alpibrusl/cancho-afm/docs/img-artifacts.png

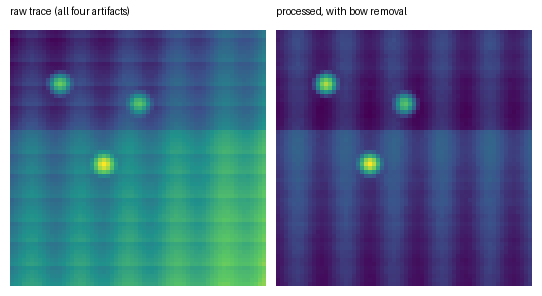
docs/img-artifacts.png
