alpibrusl/cancho-afm/docs/high-speed.md

# High-speed AFM (HS-AFM): design note

> Written 2026-11-03, **before anything is built**. Numbers are **computed from stated assumptions [A]**, taken from a search **[search]**, or not known **[unknown]**.
> Nothing here has run on a cantilever, a photodiode or a fast scanner. The twin results this note asks for are predictions, not measurements.
> This note grows `docs/design.md` section 6 and slice S7. It is the second stage: the tuning fork route (`docs/first-hardware.md`) comes first.

## What changes, and what does not

The software stays: tune, choose, approach, scan, the register table, the lock-in and PID generated from cancho, the twin. What changes is **hardware and a number of
constants**. In the order of difficulty:

| Part | Fork stage (now) | HS stage | Status |
|---|---|---|---|
| Sensor | quartz fork, current through a 1 MOhm TIA | small cantilever, **laser and quadrant photodiode** (optical beam deflection), bandwidth of several MHz | **[unknown]** which cheap photodiode and TIA; the hardest item |
| Resonance | 32.768 kHz, Q about 500 | **0.5 to 1.5 MHz**; Q 2 to 10 in liquid, 100 or more in air **[search]** (Ando: small cantilevers, 450 to 650 kHz in 2001; 1.2 MHz in later work; a commercial one is listed at 1.5 MHz in air, 0.5 MHz in liquid, 0.1 N/m) | cantilevers may be bought; **[unverified]** price and stock |
| ADC | 262 kS/s, 12 bits (Pmod AD1, AD7476A, 1 MS/s) | **4 to 10 MS/s**, 12 bits: at 8 samples per period (what our lock-in needs for a phase-free figure, `docs/converters.md`) 0.5 MHz is 4 MS/s, 1.2 MHz is 9.6 MS/s | AD7476A is too slow (already rejected); AD9226 (12 bits, parallel) is a candidate `docs/converter-candidates.md` **[search]** |
| Drive | DDS word, DAC about 262 kS/s | the same DDS, a DAC at 8 or more times f0 (4 to 10 MS/s) | **[unknown]** part |
| Detector window | 64 samples, 0.24 ms | **16 to 35 samples (2 to 4 whole cycles)**, microseconds | generated lock-in has the window as a register; lockstep run at 18, 23 and 35 (H3) |
| FPGA clock | 27 MHz, timing met at 65.9 MHz estimated | a PLL to 100 MHz or more is wanted for 10 MS/s; Tang Nano 20K has a PLL **[unverified]** | to check |
| Z scanner | the fork's piezo tube or stack, a 1 MOhm-class amplifier (`docs/amplifier.md`) | **small stack, first resonance above 100 kHz** and an amplifier with the bandwidth and slew rate for it; no ringing at the loop rate | **[unknown]**; the amplifier of `docs/amplifier.md` is far too slow for it |
| Z and XY DAC | 16 bits, SPI | settling well under the loop period; SPI at 50 MHz sets the update rate | datasheet values **[unknown]** |
| Sample | any hard sample, air | **a hard sample in air first** (calibration grating); liquid and biological samples are out of scope until air works | scope |

## The bandwidth budget (computed [A], not measured)

A loop update comes from one detector window of `W` samples at the sampling rate `fs` (8 samples per period). The pixel takes `K` updates (the twin's session uses
**K = 20**, "the loop needs about 20 to follow a feature", `host/session.cho`). The cantilever's own response time is `tau = Q / (pi f0)` (Ando) and an amplitude
change settles in about 3 tau. So the pixel time is at least `max(K W / fs, 3 tau)` and the frame rate for `N x N` pixels (trace only) is `1 / (N^2 pixel)`:

| Cantilever | fs | window | tau | pixel (K = 20) | 3 tau | 64 x 64 frame rate |
|---|---|---|---|---|---|---|
| 0.5 MHz, Q = 2 (liquid) | 4 MS/s | 64 samples, 16 us | 1.3 us | 320 us | 3.8 us | 0.8 /s |
| the same | 4 MS/s | 16 samples, 4 us | 1.3 us | 80 us | 3.8 us | 3.1 /s |
| the same | 4 MS/s | 8 samples, 2 us | 1.3 us | 40 us | 3.8 us | 6.1 /s |
| 1.2 MHz, Q = 100 (air) | 9.6 MS/s | 8 samples, 0.8 us | 26.5 us | 17 us | **80 us** | **3.1 /s** (the cantilever limits, not the detector) |

What this says, plainly:

* **The window is the first lever.** Cutting it from 64 to 8 samples gives 8 times the rate, and costs noise (a lock-in over fewer samples is noisier; see the
  noise paragraph below). It also makes the "8 samples per period" rule bite: a window under 8 samples is under one cycle, and the figure is no longer phase-free.
* **In air the cantilever's Q is the limit**, not the electronics: Q = 100 at 1.2 MHz has tau = 26 us. Fast imaging in air needs Q control (active damping) or low-Q
  cantilevers. Q control is not designed here **[unknown]**.
* **10 frames per second** (Ando reports 10 to 25 fps for his instrument **[search]**) at 64 x 64 would need a pixel of 24 us: K = 20 updates of 1.2 us, so a window of
  about 5 samples at 4 MS/s. That is below one cycle and **does not look reachable with a lock-in**. **(HS4 below measured it in the twin and corrected the premise: the window was not what limited the rate.)** Ando uses an RMS-to-DC converter or peak hold and a
  fast scanner, and attributes the limits to cantilever frequency, the RMS-DC rate and the Z scanner bandwidth **[search]**. Our honest target is **1 to 5 frames per second at 64 x 64**, not 10.
* **The one open published controller** reports 55 lines/s, a 512 x 512 image in 9.3 s, for under USD 4,000, on NI hardware (`docs/references.md`). Our cost goal
  is far below that, and our line rate on this budget is also lower **[A]**; neither is measured here.

Noise, which the table ignores: the lock-in's figure noise falls with window length, roughly as 1/sqrt(samples). A window 8 times shorter is about 2.8 times noisier **in theory**; in the twin (H3) the 18-sample window with a snapped drive gave the fork's 28 pm, because its ADC noise is small, so this is not yet seen.
Whether that leaves a usable setpoint depends on the photodiode's noise, **[unknown]**.

## What the twin can and cannot say

The twin (`sim/board.cho`, `sim/plant.cho`) models the cantilever as a Lorentzian with a first-order lag, applied **per ADC sample** with `alpha = pi f0 / (Q fs)`
(clamped at 1). An earlier version of this note said the lag was per window and clamped; that was wrong (read from a comment, not the code) and is corrected here:
at 4.5 MS/s a 0.5 MHz, Q = 5 cantilever has alpha = 0.07, so the lag is modelled, not clamped away. The first-order lag is still the simplest shape: no overshoot.

* **Can, with changes of constants only (H1):** f0 0.5 to 1.2 MHz, Q, free amplitude, the sample rate (`rf[3]`, the divider of the 27 MHz clock: 6 gives 4.5 MS/s), the
  window, pixel divider, a bigger raster; and report the **frame rate the twin predicts**. The tune stage sweeps 32.52 to 33.02 kHz in 8 Hz steps
  (`host/session.cho`): it must sweep a megahertz-scale range, with a wider step. That is a parameter, not new logic.
* **Can, with a small model (H2):** a Z scanner as a second-order system (resonance, damping), and an amplifier slew limit, in `sim/plant.cho`: it shows ringing and the
  line-rate limit **when the loop is faster than the scanner**. The parameters would be guesses until a scanner is measured.
* **Cannot:** photodiode and laser noise, optical alignment, tip-sample dynamics at speed (tapping with very small amplitudes), liquid damping, the real scanner. **(Corrected by HS5 below: the twin does model the lever's amplitude lag and the loss of signal when the tip is a full free amplitude from the sample, which is enough to show parachuting; what it does not model is listed there.)**
  The twin must say so on every HS result, as it does now.

## Slices, acceptance written first

| Slice | What | Acceptance |
|---|---|---|
| H1 | An `hs` profile in the twin: constants only, a larger raster, the frame rate printed | the full procedure (tune, approach, scan) finds a 0.5 MHz, Q = 5 cantilever and scans 64 x 64; the predicted frame rate is within 10% of the table's formula; existing tests unchanged. **Done 2026-11-03, see "What H1 found"** |
| H2 | Second-order Z scanner and amplifier slew in the twin | with the loop faster than the scanner's resonance the twin shows ringing; with a slower one it does not; a test for both. **Done 2026-11-03, see "What H2 found"** |
| H3 | The generated lock-in at 16 to 35 samples per window and 4.5 MS/s, in Verilog | lockstep with the cancho model at several windows at 6 clocks per sample; timing at the clock that gives 8 or more samples per period. **Done for the detector 2026-11-03, see "What H3 found"; the parallel ADC interface is H3b below (done as a block, not wired into the top); the fast drive DAC is not designed** |
| H4 | A video of a fast scan, labelled as a prediction | the video states the frame rate, the window and what is not modelled. **Done 2026-11-03: `docs/hs-vs-fork.mp4`** (the fork and the HS profile scan the same invented sample in simulated real time over 12 s: the fork completes 10% of a frame, the HS profile 18 frames; `docs/make_hs_video.py`) |
| H5 | Parts: a cantilever, a laser and photodiode, a fast ADC and DAC, a small stack and its amplifier | an order list as in `docs/amp-order.md`, with prices **checked** and sources, and what is still **[unknown]** marked. **Done 2026-11-03: `docs/hs-order.md`** (prices read for four lines, snippet-only for the rest, unchecked for the optics and the amplifier) |
| H6 | A measured line rate on a real small cantilever | the S7 acceptance: measured, not predicted; before this, no claim of speed |

H1 and H2 are cancho and need no hardware. H3 is generated hardware and runs under Icarus. H5 and H6 need money and a bench.

## What H1 found (twin, 2026-11-03; predictions, not measurements)

`host/session.cho` takes a profile (`ss[3]`: 0 fork, 1 hs); `host/scan_twin.cho` scans 64 x 64 over the made-up sample for either (`./scan_twin 1`). Hs profile: 4.5 MS/s
(divider 6 of the 27 MHz clock), an 18-sample window, 20 loop updates per pixel, a sweep of 100 to 899 kHz. The full procedure ran with no operator input and no refused write.

* **Tune found the cantilever:** f0 = 508.3 kHz against the twin's 500 kHz (1.7% high: the sweep step is 12.7 kHz), Q = 6 against 5. **(Since HS3, profile 1 settles 17 times longer per sweep point and finds f0 = 487.0 kHz, Q = 4 for the same lever; the 508.3 kHz was biased high by the short settle. Profile 2 is unchanged: 508.3 kHz, Q 6.)** Contact at Z = 2704 pm, as for the fork. A first sweep of 376 to 628 kHz was refused (no resonance well above the floor: the edges were only 2.7 times lower than the peak); the sweep must span several line widths.
* **The window must be a whole number of cycles.** With 16 samples (1.8 cycles at 4.5 MS/s) the amplitude figure rippled by 12% from window to window and the approach saw a false contact at the top of the Z range: the scan was all zeros. 18 samples (2.05 cycles) worked. Of the windows tried (9, 14, 15, 16, 18 at dividers 6 and 7) only 18 at divider 6 completed. **H3 below explains this and fixes it.**
* **Frame rate predicted:** 0.65 s per 64 x 64 frame with trace and retrace, 1.5 frames/s; 3.1 frames/s if only the trace were scanned (the formula's 3.05 to 3.4 /s for a 4 to 4.5 MS/s, 16 to 18 sample window). The twin counts the clocks it simulates, so this agrees with the formula by construction; it is not a check of the formula.
* **The loop did not limit the image: something in the detector did.** Over the same sample the hs image had a trace-minus-retrace rms of 87 pm against 28 pm for the fork's, and the same numbers at 20, 40 and 60 updates per pixel. This note first read that as the cost of a shorter window (about 4% of the figure). **That was wrong, corrected by H3:** it was the beating of a drive that did not span a whole number of cycles per window; with the drive snapped (below) the same 18-sample window gives 28 to 31 pm, the fork's own figure.
* **Not found, because not modelled:** photodiode noise, the real scanner (H2), liquid damping.

## What H2 found (twin, 2026-11-03; predictions, not measurements)

`sim/board.cho` has a Z scanner between the DAC and the tip: a second-order system (resonance, Q) behind an amplifier slew limit, sub-stepped so it stays stable; resonance 0 is the old ideal scanner (every earlier result is unchanged). Three tests (`tests/board_test.cho`): a step of Z
rings when the resonance is high-Q (peak over 1.5 times the step), does not when critically damped, and the slew limit bounds the speed. `./scan_twin <profile> <scanner>` scans through it; the figure is `docs/h2-scanner.png`. All of it a guess until a real scanner is measured.

HS profile, 64 x 64, the loop's gains as the session chooses them (it knows nothing of the scanner), one loop update every 4 us (250 kHz):

| Z scanner | trace-minus-retrace rms | image against the ideal scanner's |
|---|---|---|
| ideal | 87 pm | |
| 100 kHz, Q 3 | 88 pm | 0.998 |
| 70 kHz, Q 3 | 89 pm | 0.996 |
| 50 kHz, Q 3 | 94 pm | 0.979 |
| 30 kHz, Q 3 | 544 pm | 0.38: the loop rings, no image |
| 20 kHz, Q 10 | 896 pm | 0.09: the loop runs away |
| 100 kHz with a 20 pm/us amplifier | 5766 pm | 0.11: fine on the flat part, then a limit cycle from the terrace step on |

* **The scanner's resonance must be about a fifth of the loop update rate or more** for these gains: 50 kHz works, 30 kHz does not. The fork profile (a 4 kHz loop) is unaffected even by a 20 kHz, Q = 10 scanner. That is the acceptance: ringing when the loop is faster than the scanner, none when slower.
* **A slew limit breaks the loop at a step**: with 20 pm/us the amplifier cannot follow the 150 pm terrace within a loop update, and the loop oscillates. An amplifier for HS has to be specified in pm per us for the largest step, not only in bandwidth.
* **The session's gain choice (`tune.choose`) ignores the scanner.** Taking its resonance into account, or a slower loop, would widen what works, at the cost of rate. Not done; the table is for the gains as they are. **(Done in part by HS7 below: a scale from the scanner's resonance.)**
* **Not shown:** a measured scanner, hysteresis and creep, the amplifier of `docs/amplifier.md` (far too slow: its bandwidth is for the fork).

## What H3 found (generated Verilog and the twin, 2026-11-03)

**The detector.** The generated lock-in (`gen/lockin_ir.cho`, unchanged: the window is a register) was fed one sample every 6 clocks (4.5 MS/s from 27 MHz) over three windows (18, 23, 35 samples, drives at 2, 2 and 4 whole cycles): 36 windows,
**0 mismatches** against `sim/lockin.cho` under Icarus (`gen/lockin_hs_tb.v`, in `gen/check.sh`). The amplitude arrives **13 clocks (0.48 us)** after the window closes. It accepts a sample every clock, and its place and route
gave Fmax 83.3 MHz (`gen/README.md`), so **no PLL is needed for the detector**: 27 MHz allows up to 27 MS/s and the divider (3 for 9 MS/s, 6 for 4.5) is a register. What is not designed: the ADC itself (the Pmod AD1's SPI is 1 MS/s at most; a 12-bit parallel part such as the AD9226 needs a new generated interface block), the fast drive DAC, and the pins.

**Why windows failed in H1, and the fix.** A square-wave lock-in is steady only if each window sees the same sample phases, i.e. m whole cycles in n samples. Spanning "about" a whole number of cycles is not enough: windows of 2.02 cycles still beat by 6% at 400 kHz.
So `lockin.snap` (`sim/lockin.cho`) snaps the drive to `fs m / n` within 1/(8 Q) of the tuned frequency (under 2% of the amplitude lost) and takes the shortest such window; the session uses it for the HS profile after the sweep (window and tuning word, `ss[15]`, `ss[18]`). Tests: the snap picks
n = 18, m = 2 at 508 kHz, Q 6 (500 kHz, 9 samples per period exactly, word 477218588) and n = 23, m = 2 at 395 kHz; a steady sine's figure is identical every window at the snapped drive (spread of at most 1 count) and ripples by more than 1,000 counts at 1.8 cycles in 16 samples.

**In the twin**, a cantilever anywhere from 300 to 600 kHz (Q about 5) now tunes, approaches and scans 64 x 64 with no operator input, where only 500 and 600 kHz worked before:

| f0 | window | frame (trace+retrace) | trace-minus-retrace rms |
|---|---|---|---|
| 300 kHz | 29 | 1.04 s | 28 pm |
| 400 kHz | 23 | 0.82 s | 29 pm |
| 450 kHz | 20 | 0.72 s | 29 pm |
| 500 kHz | 18 | 0.65 s | 30 pm |
| 550 kHz | 16 | 0.57 s | 30 pm |
| 600 kHz | 16 | 0.57 s | 31 pm |

* **Limits**: at 4.5 MS/s a cantilever above fs / 8 = 560 kHz has fewer than 8 samples per period (the profile above 600 kHz was not made to work; it needs the divider 3 or 4, 9 or 6.75 MS/s, chosen from the tuned frequency: not done). The snap assumes the drive can be set to the snapped frequency without losing the cantilever, true for a Q of about 5 and to be checked for the 100 or more of air.
* **Twin, not measured:** the noise numbers are the twin's own (ADC noise of 2 counts, no photodiode), and its sampling is ideal.

## What H3b found (generated Verilog, 2026-11-03)

`adc_par` (`sim/adc_par.cho`, `gen/sv.cho`, details and checks in `gen/README.md`) is the interface to the AD9226 module: it drives the ADC clock, captures 12 bits and OTR, drops the 7 pipeline-filling captures and reports. Lockstep against the cancho model, a protocol test against a datasheet-based chip model with the 10 ns worst-case output delay (data settled 27 ns before capture at 13.5 MS/s), place and route 146 MHz. **The datasheet says the latency is 7 clocks, not the 3 I first assumed**, which the protocol test would have caught as well. The 7-sample delay does not matter to the lock-in (it is phase-blind), but it is a delay in the loop: 7 conversions, 1.6 us at 4.5 MS/s, before the first sample of a window reaches the detector.
Not done: wiring it into `afm_top` (a register to choose between the SPI and the parallel ADC changes the register table), pin assignments, the module's MODE strap, and a real chip.

Image processing of the result (levelling, roughness, step height, pitch, particles) is designed in `docs/image-processing.md`.

## What HS1 found (twin, 2026-11-09; predictions, not measurements)

Issue #64. The frame rate the twin predicts when the loop steps per pixel (`pixdiv`) are cut, with the Z scanner's resonance as the second axis. 64 x 64, trace and retrace, a 1,000 pm step in the made-up sample, the loop's gains as the session chooses them, no noise. **One run per cell; the twin is deterministic here.** Profile 1 is the cantilever at the twin's default Q of 5; profile 2 is the liquid one at Q 3. The figure of merit is the **trace-minus-retrace rms over columns 2 to 61** (pm): it grows when the loop lags the surface. (It is not the 87 pm of H1 above: that was another sample, with a 150 pm step, over all columns. The two are not comparable.)

| loop steps per pixel | frame time | frames/s | profile 1: ideal / 70 kHz / 50 kHz / 30 kHz scanner (pm) | profile 2: ideal / 70 / 50 / 30 kHz (pm) |
|---|---|---|---|---|
| 20 | 0.645 s | 1.55 | 9 / 10 / 12 / **525** | 9 / 14 / 112 / **306** |
| 10 | 0.323 s | 3.1 | 45 / 43 / 52 / **548** | 56 / 69 / 146 / **243** |
| 6 | 0.194 s | 5.2 | 75 / 85 / 123 / **600** | 98 / 89 / 168 / **429** |
| 4 | 0.129 s | 7.7 | 135 / 125 / 111 / **722** | **481** / **523** / **497** / **889** |

* **The frame time is the loop steps per pixel times a constant** (32,260 us per step). It is the twin counting its own clocks, so it agrees with the formula by construction; it checks nothing about a real instrument. Pinned in `tests/hs_rate.sh` for 20, 10 and 4.
* **The step height is not a sensitive figure:** every cell with a scanner at 50 kHz or faster reads the 1,000 pm step within 0.5%. The lag in the trace-minus-retrace figure is what degrades first.
* **Against an error bound of 100 pm (my proposal, not derived):** profile 1 holds it at 3.1 frames/s with a scanner of 50 kHz or faster and at 5.2 with 70 kHz or faster; profile 2 holds it at 3.1 with 70 kHz or faster, never with a 50 kHz scanner (112 pm already at 1.55 frames/s), and its 7.7 frames/s run is lost whatever the scanner is. A 30 kHz scanner fails everywhere (as in H2). **The design note's goal of 1 to 5 frames/s at 64 x 64 stands for the twin only if the Z scanner resonates at 70 kHz or more**; a 50 kHz one caps it near 3 in air and below 1.5 in liquid.
* **The detector window was not swept.** `lockin.snap` picks the shortest window of at least 16 samples that fits a whole number of cycles at 8 or more samples per period, so the window is 18 here and cannot be cut by a constant. Windows under one cycle are the fast detector of issue #67.
* **The profile called "air" is not air.** Profile 1 defaults to Q 5. Asked for a cantilever of Q 20 and Q 50 the tune stage finds Q 17 and Q 21 (probably the 12.7 kHz sweep step: the line is 25, 10 and 5 kHz wide at Q 20, 50 and 100, so it is under-sampled and Q reads low; the cause was not isolated), and **at Q 100 it refused with code 21 (peak at the edge of the sweep)**: an air cantilever was not supported by the tune. **Corrected by HS3 below: the cause was the settle time, not the step, and Q 100 now completes.** Every "air" figure above (and in `docs/liquid.md`) was a low-Q figure, which HS3 now separates from Q 100.

## What HS2 found (twin, 2026-11-09; predictions, not measurements)

Issue #65. Rule 5 of the approach, the step budget: **the approach is host-driven, one script exchange per step, and its worst case is linear in the Z range.** `approach.worst_steps(p)` is `(max_motor + 1) * ((range / dz + 2) * (dwell + 1) + 4 * dwell)`; `approach.check_budget` refuses a range whose worst case plus 1,000 steps for the other stages exceeds `session.step_budget()` (100,000, an assumption: the time per step on a real link is not measured), with **failure code 35**, before anything moves. `max_motor` is now derived from the farthest initial gap the approach is asked to cover (`session.gap_max()` = 12,000 pm; the twin's gap is 11,000), not fixed at 20, so the worst case is 4 descents instead of 21.

| Z range | worst-case steps | result |
|---|---|---|
| 10 nm | about 9,500 | completes; steps up to 6 nm within 0.2%; 8 and 20 nm steps clipped at 7.2 nm (the range) |
| 100 nm | about 86,200 | completes (contact Z 2,656 pm); steps of 3, 8, 20 and 50 nm read within 0.1% |
| 1,000 nm | about 860,000 | **refused, code 35** |

* **The 7.2 nm clip of `docs/liquid.md` was the range, not the loop.** Corrected there in place.
* **What it costs:** a range ten times larger is ten times the approach steps. Not designed: a far-field descent in bigger moves, which would cut it.
* **Two hidden limits were found on the way:** `session.consume` had its own cap of 40,000 calls (code 6), apart from the hosts' loop caps of 40,000; both now read `step_budget()`. Before #62 a spent cap ended with code 0.
* **Not covered:** the real scanner's range (a guess, about 1 um), the hysteresis and creep that a large range brings, and the force at a large range (not measured).

## Open slices, as issues

#64 HS1, #65 HS2, (the twin side of) #66 HS3, #72 HS7 and #68 HS5 are above. #67 HS4 tested its premise (above) and built nothing. Not started: #69 HS6 (hardware; blocked on a bench).

## What HS3 found (twin, 2026-11-09; predictions, not measurements)

Issue #66. An air cantilever of Q 100 has a response time tau = Q / (pi f0) = 64 us at 500 kHz, and the loop gets a new reading every 4 us. Three things were built in the twin and cancho; the Verilog and the real feedback path were not.

1. **The tune could not see a Q of 100, and the cause was the settle time.** The sweep waited 37 us per point (eleven time constants of a Q = 5 lever) before reading; a Q = 100 lever needs five of 64 us. Profile 1 now waits 630 us per point (five time constants of a Q = 200 lever); profile 2 keeps 37 us, so the liquid numbers do not move. With that alone the sweep completes (Q read as 41).
2. **A second, finer pass** (`session.sweep_hz`, `ss[26]`): when the coarse pass finds a line narrower than four of its steps (`coarse_step()` = 12.7 kHz), the line is swept again, centred, with a step of f0 / (8 Q). Q reads 85 for a Q 100 lever and 86 for a Q 200 one (it reads low as the line narrows: the settle is only five time constants at Q 200); 23 and 46 for Q 20 and 50. **A fault found on the way: my first version refined every line, and for a liquid lever (Q 3) the fine pass started at a negative frequency and the program died with a trap (exit 132).** Now refined only for narrow lines and the start is clamped at 50 kHz. `tuning_word` itself still does not guard a negative frequency; the callers do.
3. **Q control** (`sim/qcontrol.cho`, `board.set_qcontrol`, `scan_twin` arguments 22 and 23: the gain in tenths and the phase error in degrees): Q_eff = Q0 / (1 + g cos(phi)). Unstable feedback (1 + g cos(phi) below 0.1) is refused with **code 85** before anything runs. The tune sees the damped lever (Q control is on from the start; in a real instrument it would be switched on after the first sweep).

Q 100 in air, 64 x 64, the ideal scanner, a 1,000 pm step, no noise; the figure is the trace-minus-retrace rms (pm) as in HS1; one run per cell:

| loop steps per pixel | frames/s | no control | gain 4 (Q 20) | gain 9 (Q 10) | gain 19 (Q 5) |
|---|---|---|---|---|---|
| 160 | 0.19 | 39 | | 2.5 | |
| 80 | 0.39 | **74** | | 2.9 | |
| 40 | 0.77 | 466 | | 4.5 | |
| 20 | 1.55 | **1,014** | 53 | 11 | 8.1 |
| 10 | 3.1 | 802 | 567 | 93 | 38 |
| 6 | 5.2 | 535 | 935 | **92** | 90 |
| 4 | 7.7 | 363 | 954 | 467 | 85 |

* **Without Q control the lag stays under 100 pm only at 0.39 frames/s or slower**; with a gain of 9 it stays under 100 pm up to 5.2 frames/s. That is **about 13 times the rate, for a Q 10 times lower**, as tau = Q / (pi f0) suggests. A gain of 19 reproduces the Q 5 scan of HS1 exactly (8.1, 38, 90 pm), which checks the plumbing (pinned in `tests/hs_rate.sh`).
* **The lag figure is not monotonic where the loop is marginal** (gain 4 is worse than none at 6 and 4 steps per pixel). One run per cell; the table is not a smooth law.
* **The phase error matters** (gain 9): at 45 degrees the lag is 60, 66, 474 and 812 pm at 20, 10, 6 and 4 steps per pixel (fine up to 3 frames/s, lost at 5); at 80 degrees it is lost everywhere; at 100 degrees it is refused (85). The feedback path would need a phase held well inside 45 degrees. **For scale: one sample of the 4.5 MS/s converter is 40 degrees of a 500 kHz cycle**, so a path of several samples is a design problem of its own, not designed here.
* **Not modelled, and each one decides whether this pays on a real lever:** the noise the feedback adds (the main practical cost), the resonance shift (g sin(phi) / (2 Q0)), the drive range (a gain of 9 holds the free amplitude with ten times the drive), a detector or DAC that is not instantaneous, and the lever's own higher modes.
* **Verdict for #66:** in the twin the idea pays by an order of magnitude. That is the condition the issue set for generating Verilog; **the Verilog was not written**, because the part that would decide it (the feedback path's delay and noise at 500 kHz) is not in the twin. #66 stays open for the design of that path.

## What HS4 found (twin, 2026-11-09; predictions, not measurements)

Issue #67 asked for a detector that works on windows under one cycle (peak hold or RMS-DC), on the premise that **the lock-in's window is what limits the frame rate**. The issue's own condition was that HS1 show it. I tested the premise before building anything, and **it does not hold in the twin, so no detector was built.**

How it was tested. `lockin.snap` was allowed to pick a one-cycle window (m = 1, n = 9 at 500 kHz) in a scratch copy: it runs, and the figure is half as large (it is proportional to the window). At **equal frame time** the 9-sample window gets twice the loop updates per pixel. Q 100 damped to Q 5 (gain 19), and the liquid lever (Q 3); ideal Z scanner; trace-minus-retrace rms (pm); one run per cell. Gains scaled 25 to 300% of the tune's choice, the best shown:

| frames/s | lever | window 18 at the chosen gains | window 9 at the chosen gains | window 18, best gains | window 9, best gains |
|---|---|---|---|---|---|
| 5.2 | Q 5 | 90 | 89 | 90 (100%) | **31** (300%) |
| 7.7 | Q 5 | 85 | 199 | 75 (150%) | 64 (150%) |
| 10.3 | Q 5 | 310 | 540 | 50 (200%) | 56 (200%) |
| 5.2 | liquid Q 3 | 98 | 154 | 53 (300%) | 45 (300%) |
| 7.7 | liquid Q 3 | 481 | 685 | 54 (200%) | 61 (300%) |
| 10.3 | liquid Q 3 | 819 | 1,143 | 57 (300%) | 84 (300%) |

* **The shorter window is not better**: with the chosen gains it is the same or worse in every cell, and at the best gains it wins in 3 cells of 6 by a few pm and loses in the other 3. The one clear win (5.2 frames/s, Q 5: 31 against 90 pm) is a single gain scale; its neighbours (200%: 72, 150%: 89) do not repeat it. Pinned for 10.3 frames/s in `tests/hs_rate.sh`.
* **What did limit the rate is the loop gain rule.** `tune.choose` aims the loop gain at half the lever's response per update, and at 10.3 frames/s that is too timid for an ideal scanner: doubling the gains cuts the lag from 310 to 50 pm (liquid: 819 to 57 pm at three times). **So 10 frames/s at 64 x 64 is reachable in the twin with the same 18-sample window, but only with an ideal scanner** (next bullet). The earlier line of this note that 10 fps needs a window of about 5 samples was wrong about the cause.
* **That only holds with an ideal Z scanner.** At 10.3 frames/s with Q 5: a 70 kHz scanner gives 288 pm at the chosen gains, 450 at twice and 958 at three times; a 50 kHz one 267, 854 and 2,109; a 30 kHz one is lost at every gain. **Higher gains make a real scanner ring (H2 again): the scanner, not the detector and not the gain rule, is what sets the limit at 10 frames/s.** The gain rule ignores the scanner (said in H2; not fixed).
* **Detector noise did not matter in the twin** (0 to 30 counts at gains 1, 2 and 3 times: 819/205/57 pm against 780/187/64 pm at 30 counts). That is small against a figure of about 12,000 counts and is not a statement about a real photodiode and amplifier.
* **A knob was added to measure this:** `scan_twin` argument 24 scales the chosen gains in percent (`sf[6]`); 0 is as chosen.
* **What this leaves for #67:** the issue's acceptance cannot be met honestly; the condition it depended on is false in the twin. It is not closed: a peak-hold detector could still matter for reasons the twin does not model (a window of 4 us adds a delay the loop sees; a real photodiode's noise against a shorter window). Both need the hardware (#69). The next measurable thing is a loop gain rule that knows the Z scanner (issue #72).

## What HS7 found (twin, 2026-11-09; predictions, not measurements)

Issue #72. A gain rule that knows the Z scanner. **Built, with one regression on cells it was not fitted to.**

**The pattern.** On a grid of 40 twin runs (Q 5 and liquid Q 3 levers; ideal, 100, 70, 50 and 30 kHz scanners; 10, 6, 4 and 3 loop steps per pixel; gains scaled 25 to 300% of the tune's), the gain at which the lag blows up tracks the scanner's resonance against the loop's update rate (250 kHz here): a 30 kHz scanner loses the loop above about 0.6 of the chosen gains, 50 kHz above 1.1, 70 kHz above 1.6, 100 kHz above 2.3, an ideal one not below 3. Below that limit, more gain is better.

**The rule** (`tune.scanner_scale`): scale the chosen gains by `5 f_scan window_s`, kept between 0.1 and 1.5; `f_scan` unknown (0) leaves them alone. The 5 and the 1.5 are the pair, among those tried, that never made a grid cell more than 1.5 times worse than the unscaled gains and cut the geometric-mean lag from 215 to 146 pm (the best any gain gave per cell: 107 pm; 24 cells of 40 under 100 pm against 15 for the old gains and 17 for the rule). **Those figures for the rule are interpolated between the measured gain scales, not re-run at the rule's gain; only the held-out cells below are real runs of the rule.** **They are a fit to the twin's scanner model, a guess about a real scanner.**

**The refusal** (`tune.pixel_reachable`, code **36**, before the approach): a pixel shorter than 0.7 of the scanner's period (`updates * window_s * f_scan < 0.7`). In every grid cell below 0.7 the lag was 575 pm or more at any gain tried; the cells above 0.7 are not all good, and the rule says nothing about them. It is a refusal of the hopeless, not a promise.

**How the host learns the scanner:** `sf[7]` holds the resonance in Hz (0 = not known, the default); `scan_twin` argument 25 = 1 tells the host the twin's own value. In a real instrument it would be measured (a step test of the Z stack, needs #69). Every earlier result is unchanged because the default is "not known".

**Checked on cells not used to fit it** (3 pixel times of 20, 8 and 5 steps, a 20 kHz Q 10 scanner and 30, 50 and 70 kHz ones, both levers: 24 cells):

* **6 refused with 36** (20 kHz at 8 and 5 steps, 30 kHz at 5 steps); the unscaled lag of every one was 581 to 1,209 pm, so none was a good run lost.
* **7 clearly better:** 20 kHz Q 10 at 20 steps 931 to 364 pm (Q 5) and 1,255 to 237 pm (liquid); 30 kHz at 20 steps 919 to 284 and 306 to 156; at 8 steps 914 to 299 and 311 to 202; 70 kHz liquid at 5 steps 273 to 70.
* **8 unchanged** (within 10%): all six 50 kHz cells (the scale is exactly 1.0 there), and 70 kHz at 8 steps (Q 5) and 20 steps (liquid).
* **3 worse:** 70 kHz Q 5 at 20 steps 9 to 15 pm (small), 70 kHz liquid at 8 steps 77 to 94 pm, and **70 kHz Q 5 at 5 steps 90 to 142 pm (1.6 times)**. So the property "never more than 1.5 times worse" held on the grid it was fitted on and **failed once off it**. The 70 kHz cells, where the scale is 1.4 and the limit is about 1.6, sit too near the edge; a scale of 1.2 would likely fix them, and I did not tune it further on the held-out cells, which would have made them fitting data too.
* **After 100 pm:** the rule leaves a large gap to the best per-cell gain (the best gain also depends on the lever and the pixel time, not only the scanner), and a 50 kHz scanner is not helped at all.

**Not modelled:** a scanner with a slew limit (`scan_twin` scanner 3 reports 100 kHz and is treated as such), hysteresis and creep, the scanner's own Q (the table used Q 3, and Q 10 for the 20 kHz one), and the amplifier. The scanner's resonance is an input the host must be given.

## What HS5 found (twin, 2026-11-09; predictions, not measurements)

Issue #68 said the twin has no tip-sample dynamics at speed. **That was too strong, and is corrected here.** The twin has two things that produce parachuting: the amplitude follows its target with the lever's own response time (a first-order lag per ADC sample, `alpha = pi f0 / (Q fs)`, `tau = Q / (pi f0)`), and the target is the free amplitude whenever the tip is a free amplitude or more from the sample (`gap >= free`: the signal saturates, so the loop knows only that it is far, not how far). What was missing was a **measurement** of it, which this adds: `scan_twin` argument 26 = 1 prints `airborne_windows A of N`, the detector windows in which the tip was a full free amplitude from the sample (the board's `fl[44]` and `fl[45]`).

Profile 2 (liquid, Q 3), a 100 nm Z range so the made-up sample's particles (4 times the step) fit, lever 0.15 N/m (rigid sample), the loop gains as chosen, 64 x 64 with trace and retrace, one run per cell. The share of the detector windows with the tip off the surface:

| step | 1.55 frames/s | 3.1 | 5.2 | 10.3 |
|---|---|---|---|---|
| 500 pm | 0.1% | 0.3% | 0.5% | 1.8% |
| 1,000 pm | 0.5% | 0.9% | 1.6% | 4.3% |
| 4,000 pm | 1.9% | 3.9% | 7.1% | **13.0%** |
| 8,000 pm | 2.8% | 5.8% | 9.3% | 15.7% |

* **Parachuting is a fixed time, not a fixed distance.** For the 4 nm step the count of airborne windows is the same at every rate (3,039, 3,145, 3,435 and 3,142), so a faster line, with fewer windows per pixel, covers more of the image while the tip is up: 1.9% of the image at 1.55 frames/s, 13% at 10. A step under the free amplitude (500 pm against 2,000) barely does it (0.1% at the slow rate). Pinned in `tests/hs_rate.sh`.
* **More loop gain shortens it** (4 nm step, 10.3 frames/s): 3,731 airborne windows at half the chosen gains, 3,142 at the chosen, 2,146 at twice, 1,636 at three times (15.4% down to 6.8%). That is another reason the gain rule of HS4 and HS7 matters, and it pulls against the scanner's limit on gain (HS7).
* **The per-pixel force map misses the transient, and it matters more at speed.** The largest force in any detector window against the largest in the per-pixel map, in pN (the proxy is capped at 300):

| step | 1.55 frames/s | 3.1 | 5.2 | 10.3 |
|---|---|---|---|---|
| 1,000 pm | 248 / 42 | 239 / 73 | 230 / 81 | 242 / 169 |
| 4,000 pm | 300 / 118 | 300 / 205 | 300 / 202 | 300 / 300 |

  At the slow rate the map reads about a sixth of the largest window force on a 1 nm step. At the fast rate it catches up because each pixel is a few windows long, which says the map is a sampling artefact of the pixel time, not a better measurement. **Neither is a measured force**; both are the same linear law (stiffness times the amplitude given up).
* **Parameters of the model, all guesses until a lever is measured:** `tau` from the tuned Q and f0, the contact law `amplitude = free * gap / free` for gaps under the free amplitude, the loop gains, and the 2 nm free amplitude.
* **Not modelled:** a tip-sample force law (the contact is linear, not the real attraction and repulsion), the lever falling faster in contact than it rises off the surface (dissipation on contact; the twin uses one `tau` for both), motion within a cycle (the detector sees an 18-sample window, two cycles), liquid squeeze-film damping, the lever's higher modes, and a soft sample's recovery. The airborne share is a prediction of the twin's one-line physics, not of an instrument.

## Risks

1. **Optical detection** is a new subsystem (laser, alignment, quadrant photodiode, a fast TIA); none is designed. It is the schedule risk.
2. **The cantilever's Q in air** (above) limits the rate whatever we do.
3. **The Z scanner** decides the line rate; the cheap small stacks with resonances above 100 kHz are **[unverified]**.
4. **The lock-in's window** must hold a whole number of drive cycles (H3: solved by snapping the drive; the noise of a short window then equals the fork's in the twin, not yet seen with a real photodiode).
5. **The tune stage is written for a fork**: it sweeps a small range, with a long settle (20 ms), neither valid at 1 MHz.

## Sources

* Ando et al., *A high-speed atomic force microscope for studying biological macromolecules*, PNAS 98, 12468 (2001) (450 to 650 kHz cantilevers, scanner resonance-free to 60 kHz) **[search]**.
* Ando, overview of HS-AFM (2011) (10 to 25 fps; tau = Q / (pi f0); the three rate limits) **[search]**; `docs/references.md` for the open controller (HardwareX, Mendeley).
* Olympus ultra-small cantilever listing (1.5 MHz in air, 0.5 MHz in liquid, 0.1 N/m) **[search]**: a listing, not a datasheet read.
