alpibrusl/cancho-afm/docs/liquid-leak-checklist.md

# Leak test checklist (one page, to print)

> Written 2026-11-09. This is the protocol of `docs/liquid-cell.md` ("The leak test") as a form. **Nothing on it has been filled in; the test has not been run.** Fill one form per run, in pen, and copy the results into the table in `docs/liquid-cell.md`. A blank is not a pass.

**Date: ________  Done by: ______________  Run no.: ____  (1: 100 uL, 2: 100 uL tilted, 3: 200 uL, 4: 100 uL of 0.15 M salt)**

## Before (nothing is powered: supplies unplugged, scanner and board not connected)

- [ ] Holder plate, blank chip, stage and skirt are over a **dummy scanner** (or the real one, only if it may get wet)
- [ ] Tray is dry and **weighed**: ________ g
- [ ] White paper under the skirt and at the scanner's side
- [ ] Liquid: water with food colouring / 0.15 M salt water (circle one). Volume measured with a pipette: ________ uL
- [ ] A **control droplet** of the same liquid, next to the cell and not under the window, for evaporation

## During

| Step | Time | Photo taken | Droplet still under the plate? | Anything outside the droplet? |
|---|---|---|---|---|
| Droplet in | 0 min | [ ] | [ ] yes  [ ] no | |
| | 10 min | [ ] | [ ] yes  [ ] no | |
| | 30 min | [ ] | [ ] yes  [ ] no | |
| Tilt 5 degrees to the left, 1 min | | [ ] | [ ] yes  [ ] no | |
| Tilt 5 degrees to the right, 1 min | | [ ] | [ ] yes  [ ] no | |
| Tap the table 5 times | | [ ] | [ ] yes  [ ] no | |

- Run 3 only: where did the overflow of 200 uL go? ______________________________
- Runs 1 and 4 also: pipette one drop on the tray, plain water: sensor tripped [ ] yes [ ] no; salt water: [ ] yes [ ] no (write it down whatever it is)

## After

- [ ] Colour or wetness at the scanner side or on its wiring: [ ] none  [ ] some: ______________________
- [ ] White paper wet or coloured: [ ] no  [ ] yes
- [ ] Tray weighed again: ________ g. Gain: ________ g (should be about the liquid that got out)
- [ ] Control droplet's loss over 30 min, by weight or by eye: ________  (decides how often to top up)

## Pass or fail

**Pass** only if every box in "After" is clean, every drop found is in the tray, and the salt-water drop tripped the sensor. **Fail** if anything is wet at the scanner side: change the skirt or the stage and repeat the run from the top.

Result of this run: [ ] PASS  [ ] FAIL        Signed: ______________
