alpibrusl/cancho-afm/docs/registers-table.md

<!-- Generated by gen/regs_doc.cho from host/regs.cho: do not edit. -->

| Index | Address | Name | Access | Reset | Bit fields | What |
|---|---|---|---|---|---|---|
| 0 | 0x40000000 | ID | RO | 2941255681 | 32 bits | identifier and version |
| 1 | 0x40000004 | CTRL | RW | 0 | RUN [0:0], DRIVE_EN [1:1], SCAN [2:2], MANUAL [3:3], ADC_RUN [4:4], MOTOR_EN [5:5], SINE [6:6], ADC_PAR [7:7], OPT_RUN [8:8] | run bits |
| 2 | 0x40000008 | STATUS | RO | 0 | FAULT [0:0], LOOP_BUSY [1:1], OVERFLOW [2:2], SCAN_DONE [3:3], ADC_BUSY [4:4] | status bits |
| 3 | 0x4000000c | SAMPLE_DIV | RW | 103 | 32 bits | FPGA clocks between ADC conversions |
| 4 | 0x40000010 | TUNING | RW | 536870912 | 32 bits | reference phase step per sample: 2^32 f / fs |
| 5 | 0x40000014 | WINDOW | RW | 256 | 32 bits | samples per detector window |
| 6 | 0x40000018 | HALF | RW | 2 | 32 bits | SPI clocks per half SCK period |
| 7 | 0x4000001c | SHIFT | RW | 0 | 32 bits | right shift of the detector figure before the loop |
| 8 | 0x40000020 | SETPOINT | RW | 0 | 32 bits | the loop's target for the shifted figure (signed) |
| 9 | 0x40000024 | KP | RW | 0 | 32 bits | proportional gain, Q16 |
| 10 | 0x40000028 | KI | RW | 0 | 32 bits | integral gain, Q16 |
| 11 | 0x4000002c | KD | RW | 0 | 32 bits | derivative gain, Q16 |
| 12 | 0x40000030 | ILIM | RW | 0 | 32 bits | integral limit |
| 13 | 0x40000034 | ZMIN | RW | 0 | 32 bits | hardware limit on Z, low (pm) |
| 14 | 0x40000038 | ZMAX | RW | 0 | 32 bits | hardware limit on Z, high (pm) |
| 15 | 0x4000003c | ZINIT | RW | 0 | 32 bits | Z at rest (pm) |
| 16 | 0x40000040 | ZRETRACT | RW | 0 | 32 bits | Z after a fault (pm) |
| 17 | 0x40000044 | TIMEOUT | RW | 0 | 32 bits | deadman, FPGA clocks without a KICK (0 = off) |
| 18 | 0x40000048 | KICK | WO | 0 | 32 bits | any write restarts the deadman |
| 19 | 0x4000004c | DRIVE_AMP | RW | 0 | 32 bits | fork drive amplitude, DAC codes |
| 20 | 0x40000050 | DRIVE_OFFS | RW | 32768 | 32 bits | fork drive mid-scale, DAC codes |
| 21 | 0x40000054 | NPIX | RW | 2 | 32 bits | raster pixels per line |
| 22 | 0x40000058 | NLINES | RW | 1 | 32 bits | raster lines |
| 23 | 0x4000005c | X0 | RW | 0 | 32 bits | raster start X, DAC code |
| 24 | 0x40000060 | Y0 | RW | 0 | 32 bits | raster start Y, DAC code |
| 25 | 0x40000064 | DX | RW | 0 | 32 bits | raster step X, DAC codes |
| 26 | 0x40000068 | DY | RW | 0 | 32 bits | raster step Y, DAC codes |
| 27 | 0x4000006c | PIXDIV | RW | 1 | 32 bits | loop steps per raster pixel |
| 28 | 0x40000070 | MAN_Z | RW | 0 | 32 bits | Z DAC code in manual mode |
| 29 | 0x40000074 | MAN_X | RW | 0 | 32 bits | X DAC code in manual mode |
| 30 | 0x40000078 | MAN_Y | RW | 0 | 32 bits | Y DAC code in manual mode |
| 31 | 0x4000007c | MAN_D | RW | 32768 | 32 bits | drive DAC code in manual mode |
| 32 | 0x40000080 | AMP | RO | 0 | 32 bits | latest detector figure |
| 33 | 0x40000084 | ZOUT | RO | 0 | 32 bits | the Z the DAC is told (pm) |
| 34 | 0x40000088 | XOUT | RO | 0 | 32 bits | raster X, DAC code |
| 35 | 0x4000008c | YOUT | RO | 0 | 32 bits | raster Y, DAC code |
| 36 | 0x40000090 | I | RO | 0 | 32 bits | latest window's I sum |
| 37 | 0x40000094 | Q | RO | 0 | 32 bits | latest window's Q sum |
| 38 | 0x40000098 | ADC0 | RO | 0 | 32 bits | latest raw conversion, channel 0 |
| 39 | 0x4000009c | ADC1 | RO | 0 | 32 bits | latest raw conversion, channel 1 |
| 40 | 0x400000a0 | NSAMP | RO | 0 | 32 bits | conversions since ADC run was set |
| 41 | 0x400000a4 | NWIN | RO | 0 | 32 bits | windows since ADC run was set |
| 42 | 0x400000a8 | PIXLINE | RO | 0 | LINE [15:0], PIX [31:16] | raster line and pixel |
| 43 | 0x400000ac | MOTOR_CMD | WO | 0 | 32 bits | signed microsteps for the coarse motor |
| 44 | 0x400000b0 | MOTOR_RATE | RW | 27000 | 32 bits | FPGA clocks per microstep |
| 45 | 0x400000b4 | MOTOR_STATUS | RO | 0 | BUSY [0:0], ENABLED [1:1], REFUSED [2:2] | motor status bits |
| 46 | 0x400000b8 | MOTOR_POS | RO | 0 | 32 bits | microsteps since power-on (signed) |
| 47 | 0x400000bc | MOTOR_MAX | RW | 0 | 32 bits | most microsteps one command may ask for; 0 = none |
| 48 | 0x400000c0 | SINE_AMP | RW | 0 | 32 bits | sinusoidal fast axis: amplitude, X DAC codes |
| 49 | 0x400000c4 | SINE_STEP | RW | 0 | 32 bits | sinusoidal fast axis: phase step per raster tick (65536 = one line) |
| 50 | 0x400000c8 | OPT_DEFL | RO | 0 | 32 bits | optical lever: latest Pmod AD1 conversion, channel 0 (the deflection's DC level) |
| 51 | 0x400000cc | OPT_SUM | RO | 0 | 32 bits | optical lever: latest Pmod AD1 conversion, channel 1 (the photodiode sum signal) |
