alpibrusl/cancho-afm/docs/h2-scanner.png

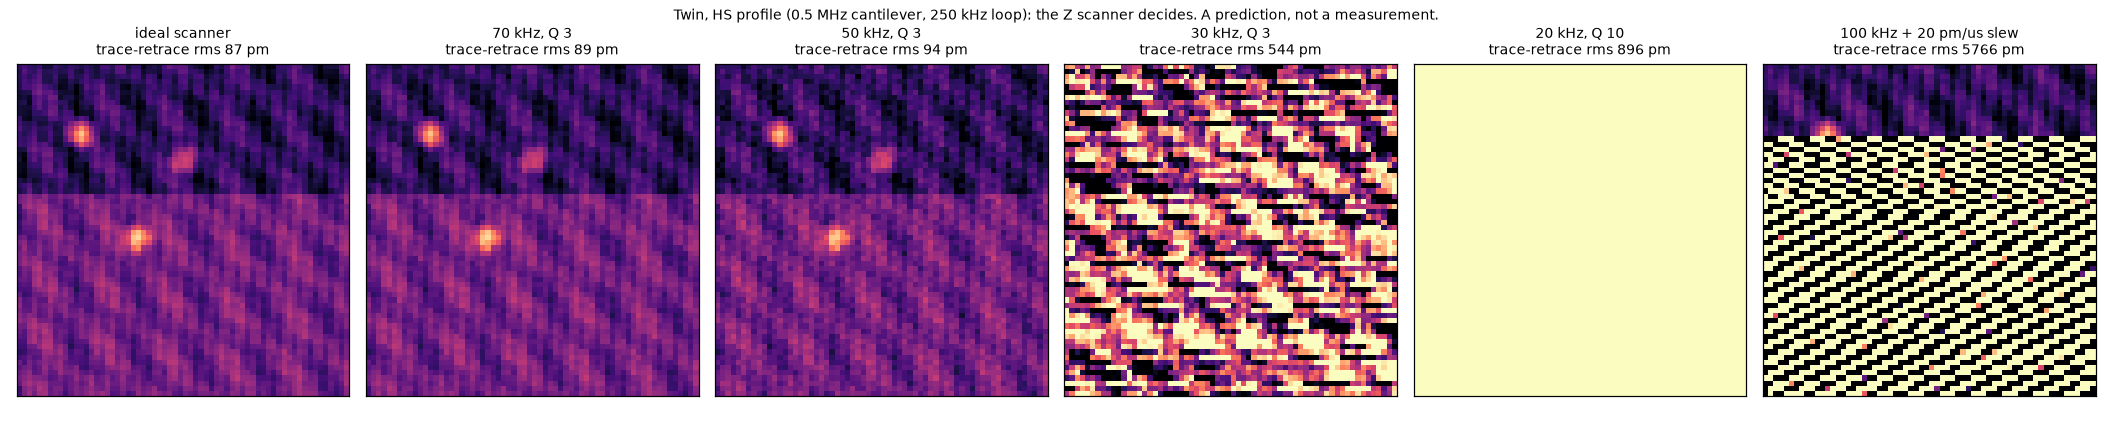
docs/h2-scanner.png
