alpibrusl/cancho-afm/docs/manual/01-parts.md

# 01 Parts

> Draft. **No part has been bought, and no source below has been checked** for whether it meets the policy's definition of open.
> "UNCONFIRMED" means exactly that: someone must open the project's files and licence and record the link and the licence name
> here before the part is bought. Quantities and models are to be filled in by the chapters that use them.

| Part | Used in | Class (policy) | Open files and licence | Notes |
|---|---|---|---|---|
| Controller FPGA board | 05 | UNCONFIRMED | Sipeed Tang Nano 20K: UNCONFIRMED. Red Pitaya: UNCONFIRMED | no ADC or DAC on the Tang Nano |
| ADC / DAC module(s) | 05 | open, to be chosen | none chosen | resolution and speed to be derived from the loop (open question) |
| Amplifier for the piezo | 04 | **ours**, to be designed | our own files, in this repository | the riskiest electronics; high voltage |
| Photodiode, four-segment | 03 | commodity | n/a | alignment is the hard part |
| Laser diode module | 03 | commodity | n/a | see chapter 00 |
| Quartz tuning fork (alternative sensor, no optics) | 03 | commodity | n/a | to be evaluated, not assumed to work |
| **Cantilevers (AFM probes)** | 03 | **closed, unavoidable** | none | the one closed part with no open alternative; says so on purpose |
| Piezo tube or plate | 04 | commodity | n/a | sets the scan range and the voltage |
| Coarse approach motor (stepper or piezo inertia) | 02 | commodity | n/a | |
| Frame and stage parts | 02 | **ours**, printed or machined | our own CAD, in this repository | mechanical design not started |
| Calibration grating | 07 | commodity, bought | n/a | stated period is the reference |
| Fasteners, wire, connectors, resistors, capacitors | all | commodity | n/a | |

Verified by: nobody yet.
