alpibrusl/cancho-afm/docs/shopping-list.xlsx

Sheet: Summary
Totals (EUR, including VAT at the rate on the Assumptions sheet)
Order | Required | Optional | Both
1 Converters | €189.42 | €38.83 | €228.25
2 Fork and piezo | €7.06 | €3.03 | €10.08
3 Tips and bench | €31.88 | €0.00 | €31.88
4 Amplifier | €33.68 | €0.00 | €33.68
5 Approach motor | €0.00 | €91.45 | €91.45
6 Frame and bench | €0.00 | €74.31 | €74.31
Subtotal | €262.04 | €207.62 | €469.66
Shipping (Assumptions) | €30.00 |  | €30.00
Breakage and spares (Assumptions) | €29.20 |  | €49.97
TOTAL | €321.24 |  | €549.63
Orders 1 to 3 are the ones to place now (the converters, the fork parts and the tip materials); 4 is the amplifier; 5 and 6 wait for the screw choice and the frame design.
Required = what the first bench needs. Optional = spares, alternatives (do not buy both motor lines) and things you may already own. Shipping is a guess.

Sheet: Shopping list
# | Order | Shop | Item | Used for | Required? | Qty | Price seen (EUR / unit) | VAT in price seen | Unit price ex VAT | Unit price incl VAT | Line total incl VAT | Code | Link | How the price was read | Notes | In Farnell cart? | Farnell link
1 | 1 Converters | DigiKey France | Pmod AD1 (12-bit ADC, 2 channels, 1 MS/s) | the fork's signal into the board | Required | 1 | €28.41 | 0% | €28.41 | €34.09 | €34.09 | Digilent 410-064; DigiKey 1286-1001-ND | https://www.digikey.fr/en/products/detail/digilent-inc/410-064/3902823 | opened | 238 in stock, Active, 4-week manufacturer lead time. Other European shops show it withdrawn. | Yes - 1 | https://es.farnell.com/digilent/410-064/m-dulo-perif-rico-pmodad1/dp/2061859
2 | 1 Converters | DigiKey France | Pmod DA3 (16-bit DAC, SMA output) | Z, X, Y and the fork drive | Required | 4 | €32.36 | 0% | €32.36 | €38.83 | €155.33 | Digilent 410-241 | https://www.digikey.fr/en/products/detail/digilent-inc/410-241/4090066 | opened | 262 in stock, Active, 4-week lead time. Four are needed. | Yes - 5 (4 + the spare in list #3) | https://es.farnell.com/digilent/410-241/dac-sin-b-fer-de-16-bits-pmod/dp/2290119
3 | 1 Converters | DigiKey France | Pmod DA3, one spare | spare | Optional | 1 | €32.36 | 0% | €32.36 | €38.83 | €38.83 | Digilent 410-241 | https://www.digikey.fr/en/products/detail/digilent-inc/410-241/4090066 | opened | Recommended: other shops no longer stock it. | Yes - included in the 5 above | https://es.farnell.com/digilent/410-241/dac-sin-b-fer-de-16-bits-pmod/dp/2290119
4 | 2 Fork and piezo | Reichelt | Watch crystal 32.768 kHz, 3x8 mm, TC38 (the tuning forks) | sensor | Required | 10 | €0.30 | 19% | €0.25 | €0.30 | €3.03 | Reichelt article 0,032768 | https://www.reichelt.com/de/en/mini-clock-crystal-32-768-khz-10-ppm-3x8-mm-tc38-0-032768-p1089.html | opened | Limited stock; 10 pF load (irrelevant here: the fork is driven, not an oscillator). The leads are fragile. | No
5 | 2 Fork and piezo | Reichelt | Watch crystal 32.768 kHz, 3x8 mm: spares | breakage | Optional | 10 | €0.30 | 19% | €0.25 | €0.30 | €3.03 | Reichelt article 0,032768 | https://www.reichelt.com/de/en/mini-clock-crystal-32-768-khz-10-ppm-3x8-mm-tc38-0-032768-p1089.html | opened |  | No
6 | 2 Fork and piezo | Reichelt | Piezo element 27 mm, 4.4 kHz (scanner disks) | scanner | Required | 10 | €0.40 | 19% | €0.34 | €0.40 | €4.03 | Reichelt EPZ-27MS44 (article 145917) | https://www.reichelt.com/de/en/shop/product/piezo_element_4_4_khz_400_ohm-145917 | opened | In stock. Capacitance and voltage rating not yet looked up (the amplifier design assumes 30 nF). | No
7 | 3 Tips and bench | Amazon.fr | Tungsten wire 0.2 mm x 5 m | tips | Required | 1 | €10.39 | 20% | €8.66 | €10.39 | €10.39 | ASIN B0G1N1SG5M (QUARKZMAN) | https://www.amazon.fr/-/en/QUARKZMAN/dp/B0G1N1SG5M | search | Only 2 were left. | No
8 | 3 Tips and bench | Amazon.fr | Sodium hydroxide 1 kg | etching the tips | Required | 1 | €12.50 | 20% | €10.42 | €12.50 | €12.50 | ASIN B0BJVRBT7V (Algin) | https://www.amazon.fr/Algin-caustique-Hydroxyde-sodium-Bo%C3%AEte/dp/B0BJVRBT7V | search | ManoMano had flakes at EUR 8.11. Corrosive: eye protection and gloves. | No
9 | 3 Tips and bench | Amazon.fr | Dupont jumper wires, 120 pieces, 20 cm | wiring the Pmods to the board | Required | 1 | €8.99 | 20% | €7.49 | €8.99 | €8.99 | ASIN B01JD5WCG2 (ELEGOO) | https://www.amazon.fr/-/en/ELEGOO-120pcs-Dupont-Breadboard-Cables/dp/B01JD5WCG2 | search | Female-female and male-female are what the Pmods need. | No
10 | 4 Amplifier | Reichelt | OPA2134PA dual FET op-amp, DIP-8 | the amplifier (8 amplifiers in 4 packages) | Required | 4 | €6.33 | 19% | €5.32 | €6.38 | €25.53 | Reichelt OPA 2134 PA | https://reichelt.com/de/en/2-channel-audio-operational-amplifier-20-v-s-8-mhz-dip-8-opa-2134-pa-p73934.html | search | DigiKey France: EUR 7.94 ex VAT. Farnell shows it no longer made. | Substitute - OPA2134UA SOIC-8 x4 + 4 Aries adapters | https://es.farnell.com/texas-instruments/opa2134ua-2k5/audio-amplifier-2-ch-soic-8/dp/3004554
11 | 4 Amplifier | Reichelt | LM4040AIZ-2.5 reference, 0.1%, TO-92 | the X/Y offset reference | Required | 1 | €1.93 | 19% | €1.62 | €1.95 | €1.95 | Reichelt LM 4040 AIZ2,5 | https://reichelt.com/de/en/shunt-voltage-reference-fixed-2-5-v-0-1-to-92-lm-4040-aiz2-5-p109411.html | search |  | Yes - 2 (SOT-23 LM4040AIM3-2.5) + SOT-23 adapters | https://es.farnell.com/texas-instruments/lm4040aim3-2-5-nopb/voltage-ref-shunt-2-5v-sot-23/dp/3009186
12 | 4 Amplifier | Reichelt | DC/DC converter 5 V to +-12 V, 1 W (TRACO TMA 0512D) | the amplifier's supply | Required | 1 | €6.15 | 19% | €5.17 | €6.20 | €6.20 | TRACO TMA 0512D | https://www.reichelt.com/de/en/shop/product/dc_dc_converter_tma_series_5_-12_v_dc-120447?r=1 | search | Unregulated, +-40 mA. The op-amps' supply current is not budgeted yet: a 2 W part may be needed. | Yes - 1 | https://es.farnell.com/tracopower/tma-0512d/converter-dc-dc-12v-1w/dp/1007515
13 | 5 Approach motor | Reichelt | Stepper motor NEMA 8, JOY-IT NEMA08-01 (motor only) | coarse approach | Optional | 1 | €21.42 | 20% | €17.85 | €21.42 | €21.42 | JOY-IT NEMA08-01 | https://www.reichelt.com/fr/fr/shop/produit/moteur_pas-a-pas_nema_08_1_8_0_6_a_3_9_v-335316 | opened | Motor only; needs a lead screw. Hold until the screw is chosen: its pitch sets the step size. | No
14 | 5 Approach motor | Reichelt | Linear actuator NEMA 8 (motor + screw), JOY-IT NEMA08-04LA | coarse approach (alternative to the line above) | Optional | 1 | €59.99 | 19% | €50.41 | €60.49 | €60.49 | JOY-IT NEMA08-04LA | https://www.reichelt.com/de/en/shop/product/linear_actuator_stepper_motor_nema_08_1_8_0_24_a_5_28_v-335319 | opened | ALTERNATIVE: do not buy both. The page does not state the screw pitch: ask before buying. | No
15 | 5 Approach motor | Amazon.fr | A4988 stepper driver modules, 5-pack | drives the motor | Optional | 1 | €9.54 | 20% | €7.95 | €9.54 | €9.54 | Paradisetronic A4988, ASIN B0872GSZ7C | https://www.amazon.fr/Paradisetronic-com-Stepper-Motor-Driver/dp/B0872GSZ7C | search | Set 1/16 microstepping (MS1 to MS3 high). | No
16 | 6 Frame and bench | Amazon.fr | Screws and nuts kit, M2 to M5, 1,430 pieces | frame | Optional | 1 | €15.99 | 20% | €13.32 | €15.99 | €15.99 | ASIN B0DQ497896 | https://www.amazon.fr/-/en/1/dp/B0DQ497896 | search | Frame not yet designed. | No
17 | 6 Frame and bench | Amazon.fr | PLA filament 1 kg (ELEGOO) | printed parts | Optional | 1 | €14.43 | 20% | €12.03 | €14.43 | €14.43 | ASIN B0CD7BTN37 | https://www.amazon.fr/ELEGOO-Imprimante-Dimensionnelle-dImpression-Imprimantes/dp/B0CD7BTN37 | search | Only if you have a 3D printer. | No
18 | 6 Frame and bench | Leroy Merlin | Anti-vibration slab 600 x 600 x 8 mm | vibration isolation | Optional | 1 | €10.90 | 20% | €9.08 | €10.90 | €10.90 | search 'dalle antivibration' |  | search | A heavy base to put it under is not priced. | No
19 | 6 Frame and bench | Amazon.fr | Spare Sipeed Tang Nano 20K | only if the first board is needed elsewhere | Optional | 1 | €32.99 | 20% | €27.49 | €32.99 | €32.99 | ASIN B0C7CSZ6GD | https://www.amazon.fr/Sipeed-Tang-Nano-20K-GW2AR-18/dp/B0C7CSZ6GD | search | That listing showed EUR 10.99 shipping. Some Tang Nano listings come without soldered header pins. | No

Sheet: Farnell cart
# | Status | Farnell code | Maker part | Item | Used for | Needed | Qty in cart | Unit ex VAT (EUR) | Line ex VAT | Line incl VAT | Stock seen | Link | Shopping list # | Notes
1 | In cart | 2290119 | 410-241 | Digilent Pmod DA3 (16-bit DAC, SMA) | Z, X, Y and the fork drive | 5 | 5 | 35.2000 | 176.00 | 212.96 | 19 in stock | https://es.farnell.com/digilent/410-241/dac-sin-b-fer-de-16-bits-pmod/dp/2290119 | 2 | 4 for the four channels + 1 spare (shopping list #3). Farnell had 19 in stock; lead time 8 weeks if it runs out.
2 | In cart | 2061859 | 410-064 | Digilent Pmod AD1 (12-bit ADC) | the fork's signal | 1 | 1 | 35.2000 | 35.20 | 42.59 | 37 in stock | https://es.farnell.com/digilent/410-064/m-dulo-perif-rico-pmodad1/dp/2061859 | 1 | Already in the cart when the cart was opened.
3 | In cart | 3004554 | OPA2134UA/2K5 | Dual FET op-amp, SOIC-8 (cut tape) | the amplifier, 8 amplifiers in 4 packages | 4 | 4 | 5.5600 | 22.24 | 26.91 | 998 in stock | https://es.farnell.com/texas-instruments/opa2134ua-2k5/audio-amplifier-2-ch-soic-8/dp/3004554 | 10 | SUBSTITUTE for the OPA2134PA (DIP-8), which Farnell does not stock. Same chip, so the simulated design stays valid. Needs an SOIC-to-DIP adapter (next line).
4 | In cart | 2476033 | LCQT-SOIC8-8 | Aries SOIC-8 to DIP-8 adapter, 2.54 mm, 7.62 mm rows | carries each OPA2134UA onto the breadboard | 4 | 4 | 5.1600 | 20.64 | 24.97 | 495 in stock | https://es.farnell.com/aries/lcqt-soic8-8/adaptador-ic-8-soic-a-dip-2-54mm/dp/2476033 |  | Replaces the Chip Quik PA0001C: EU stock, 1-2 day delivery, no US shipping charge. You solder the SOIC chip onto it.
5 | In cart | 1007515 | TMA 0512D | TRACO DC/DC 5 V to +-12 V, 1 W, +-40 mA | the amplifier's supply | 1 | 1 | 5.0100 | 5.01 | 6.06 | 524 in stock | https://es.farnell.com/tracopower/tma-0512d/converter-dc-dc-12v-1w/dp/1007515 | 12 | Check the supply current first: amplifier.md warns eight op-amps may need a 2 W part.
6 | In cart | 4143684 | BFC280823508 | Vishay trimmer capacitor 1.5 to 5 pF | the fork's transimpedance stage | 1 | 1 | 4.0800 | 4.08 | 4.94 | 733 in stock | https://es.farnell.com/vishay/bfc280823508/cond-trimmer-1-5-5pf-150v/dp/4143684 | Not priced #3
7 | In cart | 9469729 | MRS25000C6982FCT00 | Resistor 69.8 kohm 1%, axial, Vishay MRS25 | X/Y gain (amplifier.md) | 2 | 10 | 0.1300 | 1.30 | 1.57 | 6,670 in stock | https://es.farnell.com/vishay/mrs25000c6982fct00/res-69k8-1-600mw-axial-pel-c-metal/dp/9469729 | Not priced #4 | Sold in multiples of 10. The kit's resistors are probably 5 %: these are 1 %.
8 | In cart | 9467181 | MRS25000C3012FCT00 | Resistor 30.1 kohm 1%, axial | X/Y gain / reference divider | 1 | 10 | 0.1300 | 1.30 | 1.57 | 1,007 in stock | https://es.farnell.com/vishay/mrs25000c3012fct00/res-30k1-1-600mw-axial-pel-c-metal/dp/9467181 | Not priced #4 | Multiples of 10.
9 | In cart | 9463895 | MRS25000C1003FCT00 | Resistor 100 kohm 1%, axial | gain-setting resistors | 8 | 10 | 0.0802 | 0.80 | 0.97 | 200,245 in stock | https://es.farnell.com/vishay/mrs25000c1003fct00/res-100k-1-600mw-axial-pel-c-metal/dp/9463895 | Not priced #4 | Multiples of 10.
10 | In cart | 9468595 | MRS25000C4992FCT00 | Resistor 49.9 kohm 1%, axial | fork drive divider (1/50.9) | 1 | 10 | 0.0833 | 0.83 | 1.01 | 9,896 in stock | https://es.farnell.com/vishay/mrs25000c4992fct00/res-49k9-1-600mw-axial-pel-c-metal/dp/9468595 | Not priced #4 | Multiples of 10.
11 | In cart | 9468510 | MRS25000C4709FCT00 | Resistor 47 ohm 1%, axial | output isolation resistors | 3 | 10 | 0.1290 | 1.29 | 1.56 | 329,579 in stock | https://es.farnell.com/vishay/mrs25000c4709fct00/res-47r-1-600mw-axial-pel-c-metal/dp/9468510 | Not priced #4 | Multiples of 10.
12 | In cart | 9465499 | MRS25000C1004FCT00 | Resistor 1 Mohm 1%, axial | the fork's feedback resistor | 1 | 10 | 0.0899 | 0.90 | 1.09 | 121,960 in stock | https://es.farnell.com/vishay/mrs25000c1004fct00/res-1m-1-600mw-axial-pel-c-metal/dp/9465499 | Not priced #4 | The kit has 5 x 1 Mohm, probably 5 %; this one is 1 %. Multiples of 10.
13 | In cart | 1006030 | MKS2C031001A00KSSD | WIMA MKS2 film capacitor 100 nF, 40 V, 5 mm | coupling and bypass | 4 | 10 | 0.2740 | 2.74 | 3.32 | 74,758 in stock | https://es.farnell.com/wima/mks2c031001a00kssd/conden-0-1-f-63v-10-pet/dp/1006030 | Not priced #4 | Sold in tens. The cart page says 40 V, the product URL says 63 V: read the datasheet. Chosen because the Vishay MKT film parts are US stock or sold by the 2,000.
14 | In cart | 1141770 | K681J15C0GF53L2 | Vishay C0G ceramic 680 pF, 50 V, radial | the amplifier | 1 | 10 | 0.1760 | 1.76 | 2.13 | 11,680 in stock | https://es.farnell.com/vishay/k681j15c0gf53l2/conden-680pf-50v-5-c0g-np0/dp/1141770 | Not priced #4 | Sold in tens.
15 | In cart | 3619183 | FG28C0G1H331JNT00 | TDK C0G ceramic 330 pF, 50 V, radial | the amplifier | 2 | 4 | 0.1980 | 0.79 | 0.96 | 894 in stock | https://es.farnell.com/tdk/fg28c0g1h331jnt00/condensador-330pf-50v-mlcc-radial/dp/3619183 | Not priced #4
16 | In cart | 2860073 | K100J15C0GF5TH5 | Vishay C0G ceramic 10 pF, 50 V, radial | the amplifier | 1 | 10 | 0.1180 | 1.18 | 1.43 | 9,056 in stock | https://es.farnell.com/vishay/k100j15c0gf5th5/conden-10pf-50v-5-c0g-np0/dp/2860073 | Not priced #4 | Sold in tens.
17 | In cart | 3619155 | FG28C0G1H010CNT00 | TDK C0G ceramic 1 pF, 50 V, radial | the fork's transimpedance stage | 1 | 3 | 0.2250 | 0.68 | 0.82 | 485 in stock | https://es.farnell.com/tdk/fg28c0g1h010cnt00/condensador-1pf-50v-mlcc-radial/dp/3619155 | Not priced #4 | 1 pF +-0.25 pF: parasitic capacitance will matter at this value.
18 | In cart | 9451153 | MCGPR25V106M5X11 | Multicomp Pro electrolytic 10 uF, 25 V, radial | supply bypass | 4 | 6 | 0.1550 | 0.93 | 1.13 | 22,346 in stock | https://es.farnell.com/multicomp-pro/mcgpr25v106m5x11/conden-10-f-25v-20/dp/9451153 | Not priced #4
19 | In cart | 3009186 | LM4040AIM3-2.5/NOPB | TI 2.5 V shunt reference LM4040A, SOT-23 | the X/Y offset reference | 1 | 2 | 2.1100 | 4.22 | 5.11 | 19,390 in stock | https://es.farnell.com/texas-instruments/lm4040aim3-2-5-nopb/voltage-ref-shunt-2-5v-sot-23/dp/3009186 | 11 | Same chip as the designed LM4040AIZ-2.5 (TO-92, not stocked at Farnell) but surface-mount: it sits on a SOT-23 adapter. 2 bought, 1 spare.
20 | In cart | 3519238 | BAT54S RFG | Taiwan Semiconductor BAT54S dual Schottky (series pair), 30 V, SOT-23 | the ADC input clamp to 3.3 V and ground | 1 | 5 | 0.1850 | 0.93 | 1.12 | 8,369 in stock | https://es.farnell.com/search?st=3519238 | Not priced #5 | Minimum order 5, so 4 spares. Chosen over the Diotec BAT54S, which Farnell lists as an isolated dual rather than a series pair.
21 | In cart | 2476032 | LCQT-SOT23-6 | Aries SOT-23-6 to DIP-6 adapter, 2.54 mm, 7.62 mm rows | carries the LM4040 and the BAT54S onto the breadboard | 2 | 2 | 5.0400 | 10.08 | 12.20 | 535 in stock | https://es.farnell.com/aries/lcqt-sot23-6/adaptador-ic-6-sot23-a-dip-2-54mm/dp/2476032 |  | A 3-pin SOT-23 part sits on pads 1, 3 and 5 of the 6-pin footprint. The SchmartBoard kit and the Proto Advantage board were both out of stock.
22 | In cart | 9353178 | 3296W-1-102LF | Bourns 1 kohm 25-turn cermet trimmer, through-hole | X/Y offset adjustment (with the LM4040 reference) | 1 | 1 | 2.0700 | 2.07 | 2.50 | 3,794 in stock | https://es.farnell.com/bourns/3296w-1-102lf/trimmer-25-turn-1k/dp/9353178 | Not priced #5 | The "1 kohm trimmer" of amplifier.md. Price 2.07 at 1+; one bought, no spare.
 |  |  |  | Total of the lines above |  |  |  |  | 294.97 | 356.91
 |  |  |  | Cart total shown by Farnell, ex VAT (2026-11-04; shown as 356.91 incl. VAT once logged in) |  |  |  |  | 294.97
 |  |  |  | Difference (unit prices are rounded; cents only) |  |  |  |  | -0.004
 |  |  |  | Farnell: delivery free (over 75 EUR) and no shipping-from-US charge. The Chip Quik line that caused it is gone.
 |  |  |  | Logging in merged the account cart with the rebuilt one and doubled 17 lines; quantities were set back on 2026-11-04. If it happens again, check the cart after every login.
Considered and NOT in the cart
# | Verdict | Farnell code | Maker part | Item | Why |  |  | Price ex VAT (EUR) |  |  | Stock seen | Link |  | Notes
1 | Not stocked |  | OPA2134PA | Dual FET op-amp, DIP-8 (the designed part) | Farnell has only the SOIC version, which is in the cart |  |  |  |  |  |  | https://es.farnell.com/search?st=OPA2134PA |  | Search by part number returned the UA/SOIC parts only.
2 | Option | 4021475 | OP249GPZ | Analog Devices dual JFET op-amp, DIP-8 | DIP alternative: 4.7 MHz, 22 V/us (OPA2134: 8 MHz, 20 V/us); needs the sweeps in amplifier.md re-run |  |  | 9.560 |  |  |  | https://es.farnell.com/search?st=4021475
3 | Option | 3117788 | TL072CP | TI dual JFET op-amp, DIP-8 | Cheapest DIP alternative: 3 MHz, 20 V/us; needs the sweeps re-run |  |  | 1.070 |  |  |  | https://es.farnell.com/search?st=3117788
4 | Not picked | 3130159 | TL1431ACZ | ST adjustable shunt reference 2.5 V, TO-92 | Through-hole, but a different part: would need the circuit and the 1 mA minimum current checked. The LM4040 SOT-23 was chosen instead. |  |  | 0.567 |  |  |  | https://es.farnell.com/search?st=3130159 |  | Price at 5+.
5 | Out of stock | 2483414 | 204-0003-01 | SchmartBoard SOIC/SOT/SC70 to DIP kit | Would have carried the LM4040 and the BAT54S; out of stock (EUR 8.89) |  |  | 8.890 |  |  | out of stock | https://es.farnell.com/search?st=2483414
6 | Out of stock | 3549297 | PCB3007-1 | Proto Advantage SOT-23 to DIP adapter | Out of stock (EUR 2.86); the Aries SOT-23-6 board replaced it |  |  | 2.860 |  |  | out of stock | https://es.farnell.com/search?st=3549297
7 | Not picked | 4553387 | BAT54S | Diotec BAT54S, SOT-23 | Listed by Farnell as an isolated dual, not a series pair; EUR 0.58 for 5 |  |  | 0.116 |  |  | 10,859 in stock | https://es.farnell.com/search?st=4553387 |  | The Multicomp Pro BAT54S (2675347) is a series pair at EUR 1.36 for 5.
8 | Removed | 4575018 | PA0001C | Chip Quik SOIC-8 to DIP-8 adapter | Backorder (8 weeks) with EUR 18 shipping from the US; replaced by the Aries LCQT-SOIC8-8 |  |  | 5.910 |  |  | on order, 8 weeks | https://es.farnell.com/chip-quik/pa0001c/soic-8-to-dip-8-smt-adapter-1/dp/4575018
9 | Rejected | 1772015 | 2222 370 11104 | Vishay MKT 100 nF film | Minimum order 2,000 pieces (EUR 232) |  |  | 0.116 |  |  |  | https://es.farnell.com/vishay/2222-370-11104/film-capacitor/dp/1772015 |  | Price at 2,000+.
10 | Rejected | 4491920 | BFC237076104 | Vishay MKT 100 nF film | US stock: EUR 18 shipping per order and 5-7 days |  |  | 0.595 |  |  |  | https://es.farnell.com/vishay/bfc237076104/capacitor-polyester-film-film/dp/4491920
Still missing from the Farnell cart (buy elsewhere, or decide)
# | Status | List # | Shop | Item | Why not in the Farnell cart |  |  |  |  |  |  |  |  | Notes
1 | Not searched | 4, 5 | Reichelt | Watch crystals 32.768 kHz TC38 (tuning forks, plus spares) | Not searched on Farnell |  |  |  |  |  |  |  |  | Not looked up on Farnell yet; say so and it can be checked
2 | Not searched | 6 | Reichelt | Piezo disks 27 mm, 4.4 kHz (scanner) | Not searched on Farnell
3 | Not electronic | 7, 8 | Amazon.fr | Tungsten wire 0.2 mm x 5 m; sodium hydroxide 1 kg | Not Farnell goods
4 | Not searched | 9 | Amazon.fr | Dupont jumper wires, 120 pieces | Not searched on Farnell
5 | Not searched | 13 to 15 | Reichelt / Amazon.fr | Stepper motor or linear actuator NEMA 8, A4988 drivers | Not Farnell goods
6 | Not electronic | 16 to 19 | Amazon.fr / Leroy Merlin | Screws kit, PLA filament, anti-vibration slab, spare Tang Nano 20K | Not Farnell goods
7 | Not priced | Not priced | any | Fuses; SMA-to-wire leads; header pins; amplifier enclosure and connectors | Not added yet |  |  |  |  |  |  |  |  | Not looked up on Farnell yet; say so and they can be checked and added
8 | Have already | - | kit | Resistors 220, 560, 1 k, 4.7 k, 10 k, 1 M, 10 M and a 100 uF capacitor (Arduino MKR1000 bundle) | Already owned |  |  |  |  |  |  |  |  | Tolerance unknown (probably 5 %); the 1 % resistors in the cart cover the gain-setting parts. The 1 kohm and 10 kohm values for the amplifier come from the kit.

Sheet: Not priced
Item | Why it is not priced | Where to start | Rough guess (EUR) | Farnell cart
SMA-to-bare-wire leads, 4 | the Pmod DA3's output is an SMA connector; no listing with a price matched | https://www.aliexpress.com/w/wholesale-sma-pigtail-connector.html or Amazon.fr 'pigtail SMA male fil nu' | 6 to 15 in all
Header pins 2 x 20, 2.54 mm | only needed if your Tang Nano's headers are not soldered | any electronics shop | 1 to 3
Trimmer capacitor 1.5 to 5 pF | price not seen (Reichelt lists the range as 1.2 to 6 pF: read the datasheet) | https://www.reichelt.com/de/en/shop/product/trimmer_capacitor_1_5_-_5_pf_grey-21760 ; Farnell 4143684 | 2 to 4 | In cart: 4143684, EUR 4.08 (Farnell cart sheet)
Amplifier resistors, capacitors, protection diodes, fuses, a trimmer pot | a parts list exists in docs/amplifier.md but was not priced line by line | Reichelt or any distributor | 10 to 15 | Resistors, capacitors, BAT54S x5 and the 1 kohm trimmer are in the cart; still to buy: fuses (Farnell sheet, last section)
Enclosure and connectors for the amplifier | not chosen |  | 10 to 20
Eye protection and nitrile gloves | not searched |  | 5 to 10
Calibration grating (a stated period) | no European price found; a TGZ-series step grating was USD 250 unmounted at Ted Pella | https://www.tedpella.com/calibration_html/AFM_STM_SPM_Calibration_Specimens.aspx ; ask NT-MDT's European office for a quote | 260 to 300. Start with a CD or DVD instead: free
Heavy base for the vibration slab (stone or tile) | not searched |  | 10 to 30
Circuit boards from a fab (a few small ones) | JLCPCB about USD 2 for 5 small boards plus shipping and import VAT, from forum posts only |  | 10 to 25
Stepper lead screw (if you buy the plain motor) | the pitch decides the step size and is not chosen; AliExpress had a NEMA 8 with a 0.635 mm screw at about USD 30 | https://www.aliexpress.com/item/32622031618.html | about 28 plus shipping and possibly import VAT
Tools if you own none: multimeter, soldering station, 10x to 30x loupe, tweezers | not repriced |  | 80 to 165

Sheet: Assumptions
Assumptions (edit the yellow cells; everything else recalculates)
Item | Value | Note
VAT rate applied to every line | 20% | France 20%. Spain: 21%. Prices seen on a shop page are first converted to net, then this rate is applied.
Breakage and spares on the subtotal | 10% | Tips and forks break. The project's cost estimate (docs/cost.md) uses 10%.
Shipping, all orders (EUR) | €30.00 | GUESS: about 3 orders x EUR 10. No shop's shipping cost was visible when the prices were read; replace with the real quotes.
VAT rate for the Farnell cart (Spain) | 21% | Spain 21%. Farnell shows every price excluding VAT; the cart on 2026-11-03 showed EUR 266.11 ex VAT, EUR 343.77 with VAT and the EUR 18 US-stock shipping charge.
Sources and caveats
Prices were read on 2026-11-01 and 2026-11-02 from shop pages ('opened') or from search-result summaries ('search'); stock and prices change, so check each page before paying.
'Price seen' is per unit as shown on the shop page; the 'VAT in price seen' column says whether it already includes VAT (DigiKey shows prices excluding VAT; Reichelt's German pages include 19% German VAT; Amazon.fr and Reichelt's French shop include 20%).
Items marked Optional are in the 'with optional' total but not in the 'required' total.
Items with no price are on the 'Not priced' sheet and are not in any total.
Farnell cart sheet: prices are Farnell Spain, ex VAT, at the quantity-break shown for that quantity on 2026-11-03; links are the product pages as opened in the cart. A row says 'search' in its link note only where the product page was reached through Farnell's search by code.
