alpibrusl/cancho-afm/hw/kicad/amp_bom.csv

value | footprint | quantity | references | what to buy
330p | C_Disc_D5.0mm_W2.5mm_P5.00mm | 2 | C1 C2 | ceramic C0G/NP0, 50 V, 5 mm pitch (the compensation capacitors set the amplifier's stability: not X7R)
680p | C_Disc_D5.0mm_W2.5mm_P5.00mm | 1 | C3 | ceramic C0G/NP0, 50 V, 5 mm pitch (as above)
100n | C_Disc_D5.0mm_W2.5mm_P5.00mm | 8 | C4 C6 C8 C10 C17 C19 C21 C23 | ceramic X7R, 50 V, 5 mm pitch (decoupling)
10u | C_Disc_D6.0mm_W4.4mm_P5.00mm | 8 | C5 C7 C9 C11 C18 C20 C22 C24 | radial multilayer ceramic 10 uF, X7R, 25 V or more, 5 mm pitch, NOT polarised (the -12 V rail reverses the sense an electrolytic needs)
100n | C_Rect_L7.2mm_W3.0mm_P5.00mm_FKS2_FKP2_MKS2_MKP2 | 2 | C12 C15 | film (PET/PP) 100 nF, 63 V or more, 5 mm pitch (signal coupling in the fork path)
1.5-5p trim | C_Disc_D5.0mm_W2.5mm_P5.00mm | 1 | C13 | trimmer capacitor 1.5-5 pF, through hole (the footprint is a PLACEHOLDER: take the pitch from the part's datasheet)
1p | C_Disc_D5.0mm_W2.5mm_P5.00mm | 1 | C14 | ceramic C0G/NP0, 50 V, 5 mm pitch, +-0.25 pF or better
10p | C_Disc_D5.0mm_W2.5mm_P5.00mm | 1 | C16 | ceramic C0G/NP0, 50 V, 5 mm pitch
1N5819 | D_DO-41_SOD81_P10.16mm_Horizontal | 2 | D1 D2 | Schottky diode 1 A, DO-41 (reverse-supply protection, across the rails)
BAT54S | SOT-23 | 1 | D3 | BAT54S dual series Schottky, SOT-23 (surface mount)
500mA | Fuse_1206_3216Metric | 2 | F1 F2 | fuse or resettable PTC 500 mA, 1206 (surface mount)
header | PinHeader_1x02_P2.54mm_Vertical | 10 | J1 J2 J3 J4 J5 J6 J8 J9 J10 J11 | pin header 2.54 mm, 2 pins (a piezo or DAC lead, or a screw terminal of the same pitch)
header | PinHeader_1x03_P2.54mm_Vertical | 1 | J7 | pin header 2.54 mm, 3 pins (a piezo or DAC lead, or a screw terminal of the same pitch)
10k | R_Axial_DIN0207_L6.3mm_D2.5mm_P10.16mm_Horizontal | 6 | R1 R4 R7 R19 R22 R23 | metal film 1 %, 0207
69.8k | R_Axial_DIN0207_L6.3mm_D2.5mm_P10.16mm_Horizontal | 2 | R2 R5 | metal film 1 %, 0207 (E96 value: it sets the X/Y gain 7.98)
47 | R_Axial_DIN0207_L6.3mm_D2.5mm_P10.16mm_Horizontal | 3 | R3 R6 R9 | metal film 1 %, 0207
30.1k | R_Axial_DIN0207_L6.3mm_D2.5mm_P10.16mm_Horizontal | 1 | R8 | metal film 1 %, 0207 (E96 value: it sets the Z gain 4.01)
9.53k | R_Axial_DIN0207_L6.3mm_D2.5mm_P10.16mm_Horizontal | 1 | R10 | metal film 1 %, 0207 (E96 value)
2.2k | R_Axial_DIN0207_L6.3mm_D2.5mm_P10.16mm_Horizontal | 1 | R11 | metal film 1 %, 0207
2.7k | R_Axial_DIN0207_L6.3mm_D2.5mm_P10.16mm_Horizontal | 1 | R12 | metal film 1 %, 0207
49.9k | R_Axial_DIN0207_L6.3mm_D2.5mm_P10.16mm_Horizontal | 1 | R13 | metal film 1 %, 0207 (E96 value: the fork drive divider 1/50.9)
1k | R_Axial_DIN0207_L6.3mm_D2.5mm_P10.16mm_Horizontal | 2 | R14 R21 | metal film 1 %, 0207
100k | R_Axial_DIN0207_L6.3mm_D2.5mm_P10.16mm_Horizontal | 4 | R15 R16 R18 R20 | metal film 1 %, 0207
1M | R_Axial_DIN0207_L6.3mm_D2.5mm_P10.16mm_Horizontal | 1 | R17 | metal film 1 %, 0207
1k | Potentiometer_Bourns_3296W_Vertical | 1 | RV1 | multi-turn trimmer 1 k, Bourns 3296W style (sets VREF to 1.43 V)
OPA2134PA | DIP-8_W7.62mm | 4 | U1 U2 U4 U5 | OPA2134PA dual FET op-amp, DIP-8 (the simulation's reference)
LM4040-2.5 | SOT-23 | 1 | U3 | LM4040 2.5 V shunt reference, SOT-23 (surface mount); B grade (0.2 %) or better
