alpibrusl/cancho-afm/docs/manual/02-frame-stage-approach.md

# 02 Frame, stage and approach

> Draft, unverified. Nothing here has been built or measured.

**Goal.** The mechanics that hold the tip and the sample, and the coarse approach that brings them within the scanner's range.

**Parts.** See [01-parts.md](01-parts.md).

**Steps.** To be written when the design question for this chapter is settled. Notes so far: Stiffness and low drift matter more than anything else here; a design is chosen by the first open question in design.md, not by this draft. Reference designs to read: the 3D-printed and optical-pickup projects in docs/references.md.

**Check.** The stage's lowest resonance, and the drift over ten minutes with nothing running, measured and written in. (pass criterion to be written before the step is done.)

**If it fails.** Not yet known.

Verified by: nobody yet.
