alpibrusl/cancho-afm/docs/manual/03-sensor.md

# 03 Sensor

> Draft, unverified. Nothing here has been built or measured.

**Goal.** Turn the tip's motion into a voltage the controller can read.

**Parts.** See [01-parts.md](01-parts.md).

**Steps.** To be written when the design question for this chapter is settled. Notes so far: Either optical beam deflection (a laser on the cantilever, a four-segment photodiode, alignment screws) or a quartz tuning fork. The choice is open (design.md §5).

**Check.** With the cantilever mounted and no surface, the sensor's noise and its drive response (a resonance peak) are seen on the oscilloscope. (pass criterion to be written before the step is done.)

**If it fails.** Not yet known.

Verified by: nobody yet.
