alpibrusl/cancho-afm/docs/manual/04-scanner-and-amplifier.md

# 04 Scanner and amplifier

> Draft, unverified. Nothing here has been built or measured.

**Goal.** Move the sample in XY and the tip or sample in Z, by the voltage the controller commands.

**Parts.** See [01-parts.md](01-parts.md).

**Steps.** To be written when the design question for this chapter is settled. Notes so far: The piezo's scan range and voltage set the amplifier. The amplifier is ours or an open design, fused and enclosed (chapter 00).

**Check.** With the scanner disconnected, a commanded ramp appears on the amplifier output, at the right slope, with the limit not exceeded. Then with a dummy load, then the scanner. (pass criterion to be written before the step is done.)

**If it fails.** Not yet known.

Verified by: nobody yet.
