alpibrusl/cancho-afm/docs/manual/06-first-power-up.md

# 06 First power-up and checks

> Draft, unverified. Nothing here has been built or measured.

**Goal.** Everything tested before a tip meets a surface.

**Parts.** See [01-parts.md](01-parts.md).

**Steps.** To be written when the design question for this chapter is settled. Notes so far: The order: the amplifier alone, the limit and deadman with no tip, then the sensor, then the whole loop on a test circuit.

**Check.** The deadman is seen to retract the Z drive within its declared time, and the limit is seen to refuse, with the tip not yet mounted. (pass criterion to be written before the step is done.)

**If it fails.** Not yet known.

Verified by: nobody yet.
