alpibrusl/cancho-afm/docs/manual/07-first-image.md

# 07 First image and calibration

> Draft, unverified. Nothing here has been built or measured.

**Goal.** The first scan, of a calibration grating, and the comparison to its stated period.

**Parts.** See [01-parts.md](01-parts.md).

**Steps.** To be written when the design question for this chapter is settled. Notes so far: Start with a large, slow, low-gain scan and the approach with an operator present.

**Check.** The grating's period measured from the image is compared with the stated period and the difference written down. (pass criterion to be written before the step is done.)

**If it fails.** Not yet known.

Verified by: nobody yet.
