alpibrusl/cancho-afm/hw/kicad/amp.kicad_pcb

## KiCad design hw/kicad/amp.kicad_pcb (2026-11-03)

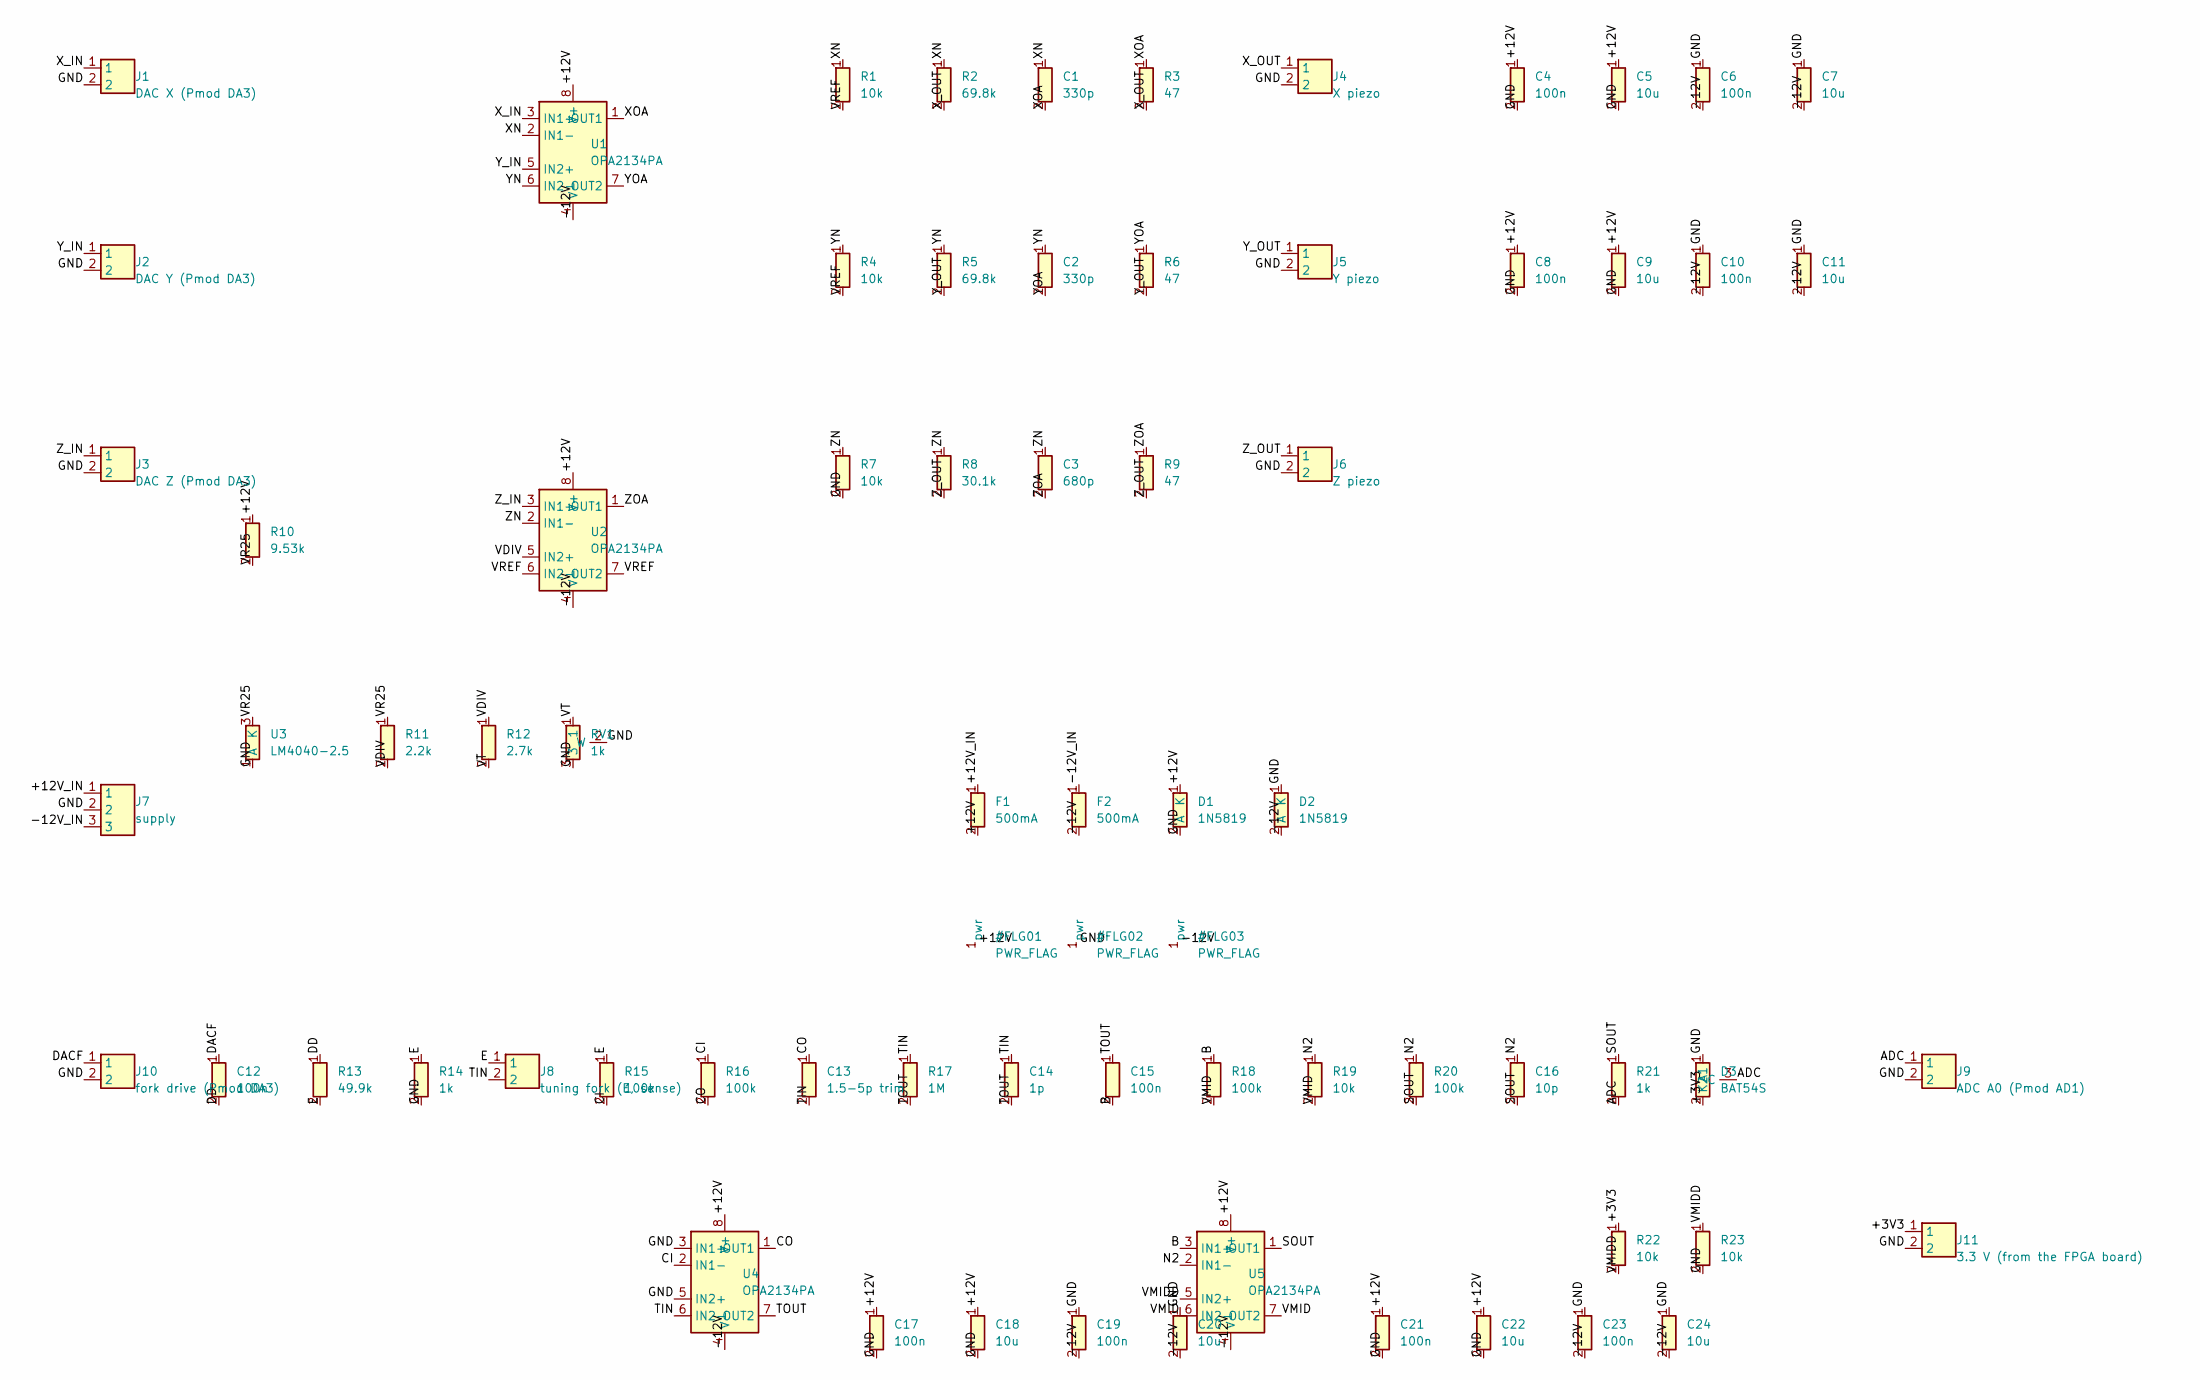
[picture p3: schematic amp.kicad_sch, cancho-afm: piezo driver board]

Parts:
C1, C2: 330p; C_Disc_D5.0mm_W2.5mm_P5.00mm
C3: 680p; C_Disc_D5.0mm_W2.5mm_P5.00mm
C4, C6, C8, C10, C17, C19, C21, C23: 100n; C_Disc_D5.0mm_W2.5mm_P5.00mm
C5, C7, C9, C11, C18, C20, C22, C24: 10u; C_Disc_D6.0mm_W4.4mm_P5.00mm
C12, C15: 100n; C_Rect_L7.2mm_W3.0mm_P5.00mm_FKS2_FKP2_MKS2_MKP2
C13: 1.5-5p trim; C_Disc_D5.0mm_W2.5mm_P5.00mm
C14: 1p; C_Disc_D5.0mm_W2.5mm_P5.00mm
C16: 10p; C_Disc_D5.0mm_W2.5mm_P5.00mm
D1, D2: 1N5819; D_DO-41_SOD81_P10.16mm_Horizontal
D3: BAT54S; SOT-23
F1, F2: 500mA; Fuse_1206_3216Metric
J1: DAC X (Pmod DA3); PinHeader_1x02_P2.54mm_Vertical
J2: DAC Y (Pmod DA3); PinHeader_1x02_P2.54mm_Vertical
J3: DAC Z (Pmod DA3); PinHeader_1x02_P2.54mm_Vertical
J4: X piezo; PinHeader_1x02_P2.54mm_Vertical
J5: Y piezo; PinHeader_1x02_P2.54mm_Vertical
J6: Z piezo; PinHeader_1x02_P2.54mm_Vertical
J7: supply; PinHeader_1x03_P2.54mm_Vertical
J8: tuning fork (E, sense); PinHeader_1x02_P2.54mm_Vertical
J9: ADC A0 (Pmod AD1); PinHeader_1x02_P2.54mm_Vertical
J10: fork drive (Pmod DA3); PinHeader_1x02_P2.54mm_Vertical
J11: 3.3 V (from the FPGA board); PinHeader_1x02_P2.54mm_Vertical
R1, R4, R7, R19, R22, R23: 10k; R_Axial_DIN0207_L6.3mm_D2.5mm_P10.16mm_Horizontal
R2, R5: 69.8k; R_Axial_DIN0207_L6.3mm_D2.5mm_P10.16mm_Horizontal
R3, R6, R9: 47; R_Axial_DIN0207_L6.3mm_D2.5mm_P10.16mm_Horizontal
R8: 30.1k; R_Axial_DIN0207_L6.3mm_D2.5mm_P10.16mm_Horizontal
R10: 9.53k; R_Axial_DIN0207_L6.3mm_D2.5mm_P10.16mm_Horizontal
R11: 2.2k; R_Axial_DIN0207_L6.3mm_D2.5mm_P10.16mm_Horizontal
R12: 2.7k; R_Axial_DIN0207_L6.3mm_D2.5mm_P10.16mm_Horizontal
R13: 49.9k; R_Axial_DIN0207_L6.3mm_D2.5mm_P10.16mm_Horizontal
R14, R21: 1k; R_Axial_DIN0207_L6.3mm_D2.5mm_P10.16mm_Horizontal
R15, R16, R18, R20: 100k; R_Axial_DIN0207_L6.3mm_D2.5mm_P10.16mm_Horizontal
R17: 1M; R_Axial_DIN0207_L6.3mm_D2.5mm_P10.16mm_Horizontal
RV1: 1k; Potentiometer_Bourns_3296W_Vertical
U1, U2, U4, U5: OPA2134PA; DIP-8_W7.62mm
U3: LM4040-2.5; SOT-23

Connections:
/+3V3: D3.2 (K2), J11.1, R22.1
/+12V: C4.1, C5.1, C8.1, C9.1, C17.1, C18.1, C21.1, C22.1, D1.1 (K), F1.2, R10.1, U1.8 (V+), U2.8 (V+), U4.8 (V+), U5.8 (V+)
/+12V_IN: F1.1, J7.1
/-12V: C6.2, C7.2, C10.2, C11.2, C19.2, C20.2, C23.2, C24.2, D2.2 (A), F2.2, U1.4 (V-), U2.4 (V-), U4.4 (V-), U5.4 (V-)
/-12V_IN: F2.1, J7.3
/ADC: D3.3 (C), J9.1, R21.2
/B: C15.2, R18.1, U5.3 (IN1+)
/CI: R15.2, R16.1, U4.2 (IN1-)
/CO: C13.1, R16.2, U4.1 (OUT1)
/DACF: C12.1, J10.1
/DD: C12.2, R13.1
/E: J8.1, R13.2, R14.1, R15.1
/GND: C4.2, C5.2, C6.1, C7.1, C8.2, C9.2, C10.1, C11.1, C17.2, C18.2, C19.1, C20.1, C21.2, C22.2, C23.1, C24.1, D1.2 (A), D2.1 (K), D3.1 (A1), J1.2, J2.2, J3.2, J4.2, J5.2, J6.2, J7.2, J9.2, J10.2, J11.2, R7.2, R14.2, R23.2, RV1.2 (W), RV1.3, U3.1 (A), U4.3 (IN1+), U4.5 (IN2+)
/N2: C16.1, R19.1, R20.1, U5.2 (IN1-)
/SOUT: C16.2, R20.2, R21.1, U5.1 (OUT1)
/TIN: C13.2, C14.1, J8.2, R17.1, U4.6 (IN2-)
/TOUT: C14.2, C15.1, R17.2, U4.7 (OUT2)
/VDIV: R11.2, R12.1, U2.5 (IN2+)
/VMID: R18.2, R19.2, U5.6 (IN2-), U5.7 (OUT2)
/VMIDD: R22.2, R23.1, U5.5 (IN2+)
/VR25: R10.2, R11.1, U3.3 (K)
/VREF: R1.2, R4.2, U2.6 (IN2-), U2.7 (OUT2)
/VT: R12.2, RV1.1
/XN: C1.1, R1.1, R2.1, U1.2 (IN1-)
/XOA: C1.2, R3.1, U1.1 (OUT1)
/X_IN: J1.1, U1.3 (IN1+)
/X_OUT: J4.1, R2.2, R3.2
/YN: C2.1, R4.1, R5.1, U1.6 (IN2-)
/YOA: C2.2, R6.1, U1.7 (OUT2)
/Y_IN: J2.1, U1.5 (IN2+)
/Y_OUT: J5.1, R5.2, R6.2
/ZN: C3.1, R7.1, R8.1, U2.2 (IN1-)
/ZOA: C3.2, R9.1, U2.1 (OUT1)
/Z_IN: J3.1, U2.3 (IN1+)
/Z_OUT: J6.1, R8.2, R9.2

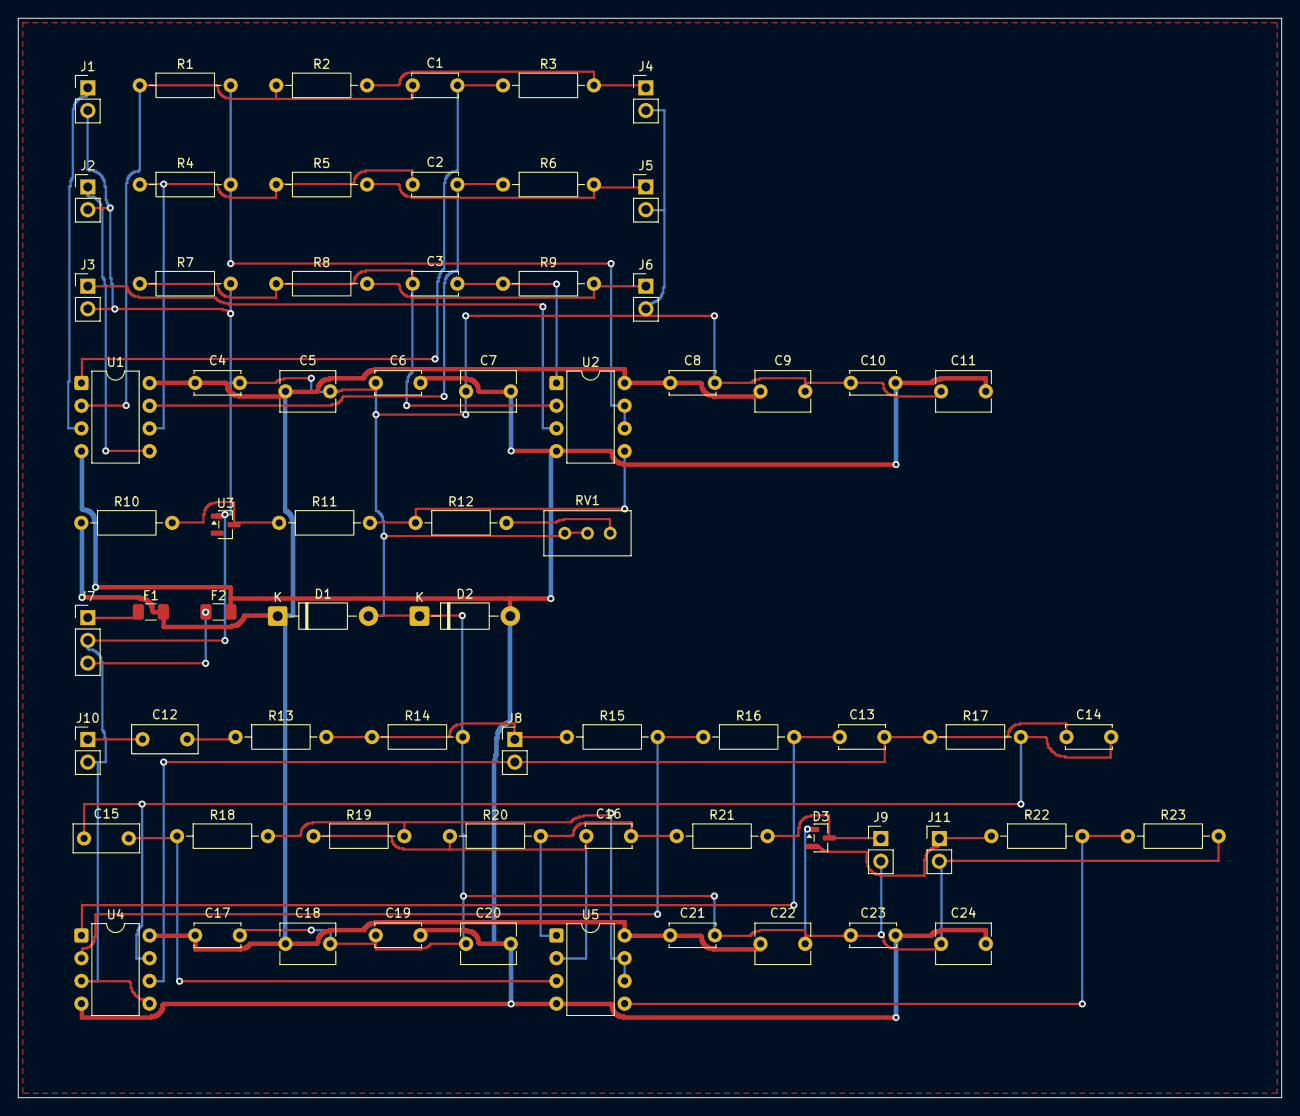
[picture p4: board amp.kicad_pcb from above]

Board: 2 copper layers, 141.3 x 120.7 mm, 69 parts (0 on the bottom side), 35 nets.
