alpibrusl/cancho-afm/(commit log)

2026-11-02 Models of the controller: PID, raster, lock-in detector, SPI masters, motor driver, tune and approach
    Integer, picometre models written to be the reference the generated SystemVerilog must equal, each with tests: a fixed-point PID with anti-windup
    and a Z limit; the XY raster; a square-wave I/Q lock-in with a digit-by-digit square root; cycle-accurate models of the Pmod AD1 and DA3 SPI
    masters and of an A4988-style stepper driver; and the host-side tune (resonance finder and gain rule) and approach (a state machine that refuses
    unsafe parameters), checked against a model of a resonator and a surface. The simulations found two design problems that are fixed in the rules:
    Q8 gains are too coar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
2026-11-02 Generator: SystemVerilog from cancho for the loop, raster, detector, SPI, motor and the whole board
    One dataflow graph per block gives widths from declared input ranges and automatic pipeline registers; the SPI masters, stepper driver, serial bridge,
    register file and top level are emitted as text. Every block is checked by a cancho model clock by clock (lockstep) and by a protocol or system
    testbench under Icarus Verilog, and every check was shown able to fail by deliberate breaks of the Verilog. Pins (gen/afm_top.cst), a bitstream
    build script (gen/build_fpga.sh) and nextpnr timing harnesses are included. test_all.sh is the gate.
    The checks found real bugs: a divisor changed mid-frame str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
    [afm_top_tb.v, lockin_tb.v, motor_tb.v, pid_step_tb.v, raster_step_tb.v, raster_tb.v, spi_lockstep_tb.v]
2026-11-02 Host program, software twin and the register table
    host/regs.cho is the one place the 48 registers are written; the host and the twin use its names, and cancho programs generate from it the
    cancho-hdl contract, a Verilog check of the real register file and the doc table. sim/board.cho is a software twin of the board (same register map,
    the validated models, a fork, tip and grating) and host/session.cho is the whole automatic run (check, sweep, approach with the motor, hand-off,
    scan, measure) as scripts of register operations; it passes against the twin, which agrees with the Verilog simulation on the free figure, the
    settled Z, the limit, the deadman and where a scan ends. host/bringup.cho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
2026-11-02 Hardware: amplifier design with ngspice simulations, the register contract and header, a bench script
    hw/amp: X/Y and Z piezo drivers and the fork's drive and receive chain, simulated in ngspice with a behavioural op-amp (a design change was forced:
    feedback from the load side plus a small capacitor from the op-amp output, because the op-amp's output resistance alone caused a 2.4 V overshoot).
    hw/afm.chw is the cancho-hdl contract (chw check accepts it) and hw/afm.h the C header made from it, both generated from host/regs.cho.
2026-11-02 Docs and project page: policy, costs for France and Spain, converters, amplifier, simulator, first hardware, tutorial
    Policy revised (cheap parts, open designs we make; EUPL-1.2 / CERN-OHL-S-2.0 / CC BY 4.0 proposed), the shopping list priced from European shops
    with links and codes (and as a spreadsheet), converter requirements and candidates, the amplifier, the simulator and host, the register map, the first
    run on a real board, and the landing page with a step-by-step tutorial including a high-speed section. Everything is marked simulated, measured or
    planned. The paper PDF is not included: its notice forbids further distribution.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
    [shopping-list.xlsx]
2026-11-02 PID gains in Q16: a real, slow integral term
    The Q8 gains were too coarse for a slow tuning fork and could not express an integral time long enough for stability, so the loop had to be
    proportional-only. Gains are now 16-bit over 65536 in the model, the generated graph (ranges, divisor), the twin, the host's gain rule and the
    tests; the Verilog is regenerated and passes the same checks (the closed-loop hardware simulation still settles Z at 1,599 pm).
    On the twin the rule now gives kp 2,556 and ki 16 for a Q = 500 fork, the end-to-end chain passes with an integral term, and a scanned 100 pm
    grating comes out at about 89 pm at 60 loop steps per pixel (it was about 48 pm proportional-only).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
    [afm_top_tb.v]
2026-11-02 Sinusoidal fast axis: raster_sine block, SINE mode bit, registers 48 and 49
    Generated raster_sine (lockstep with sim/raster_sine.cho over 12000 clocks,
    varying amplitude and restarts), wired into afm_top behind CTRL bit 6, in the
    register table, contract, header, twin and system test (phase 8).
2026-11-02 KiCad schematic of the piezo driver board, and a cancho-ui console fed by the twin
    hw/kicad: generated schematic (ERC clean, nets checked against the simulated
    circuits; the check found z_amp.cir carrying Cf 330 pF against the design's
    680 pF: corrected). ui/: a cancho-ui page showing a software twin run
    (host/twin_export.cho writes the JSON).
    [amp.kicad_sch]
2026-11-02 hw/kicad: the fork's front end drawn and checked against fork_fe.cir
    [amp.kicad_sch]
2026-11-02 Live console: ui/live.cui, a twin producer and a read-only board monitor
2026-11-02 host/serve.cho: the live console's server, in cancho (reads the board, serves JSON and the page)
2026-11-02 hw/kicad: a placed board from the netlist (no tracks yet); BAT54S clamp as one part
    [amp.kicad_pcb, amp.kicad_sch]
2026-11-02 hw/kicad: a router in cancho; the board is routed and passes KiCad's DRC
    [amp.kicad_pcb]
2026-11-02 hw/kicad: wider power tracks, a keep-out around the 1 Mohm node, ground routed; 45 vias
    [amp.kicad_pcb]
2026-11-02 Order list and BOM for the piezo driver board; 10 uF footprint corrected
    [amp.kicad_pcb, amp.kicad_sch, amp_bom.csv]
2026-11-03 docs: a demo video of the automatic procedure on the software twin
    The frames are drawn from host/live_twin.cho and host/demo_twin.cho output; docs/make_demo_video.py says how.
2026-11-03 twin: a made-up sample (grating, terrace, particles) and a 64 x 64 scan program, with a video
    host/scan_twin.cho runs the automatic procedure up to the closed loop, then a 64 x 64 raster; sim/board.cho's surface gains the sample when fl[10] > 0 (default unchanged, gate passes).
2026-11-03 docs/high-speed.md: the HS-AFM stage designed before it is built
2026-11-03 H1: a high-speed profile in the twin session, a 64 x 64 scan of it, and what it found
    Corrects docs/high-speed.md: the twin's cantilever lag is per sample, not per window.
2026-11-03 H2: a Z scanner (resonance, Q, amplifier slew) in the twin, three tests, and what it found
    Resonance 0 is the old ideal scanner, so earlier results are unchanged; fl grows to 24 slots.
2026-11-03 H3: the fast lock-in in Verilog at 6 clocks per sample, and the drive snapped to whole cycles
    lockin.snap picks the window and the drive (fs m / n); the HS session uses it after the sweep. Corrects docs/high-speed.md: H1 blamed the short window for 87 pm of noise; it was the drive not spanning whole cycles (28-31 pm with the snap).
    [lockin_hs_tb.v]
2026-11-03 H5: docs/hs-order.md, the parts of the high-speed stage, prices tagged read, snippet or unchecked
2026-11-03 H3b: the interface to the AD9226 module, generated and checked in simulation
    sim/adc_par.cho model, generated adc_par, cancho tests against a behavioural chip, Icarus lockstep (0 mismatches) and protocol test against a datasheet-based chip (worst-case 10 ns output delay), place and route 146 MHz. Latency is 7 clocks (read from the datasheet), not the 3 first assumed. Not in afm_top.
2026-11-03 I2: metrics of an AFM image (roughness, step fit, joint sinusoid fit of a grating), scored on synthetic images and the twin's scan (#22)
2026-11-03 I3: particle finder and particles.csv (#23)
    * I3: particle finder (window-median background, robust threshold, 8-connected groups) and particles.csv from the twin's scan
    * I3: the particles.csv -> cancho-table flow test; note updated
    ---------
2026-11-03 I4: drift of the sample from the trace and the retrace (lag, drift and height drift fitted jointly), drift in the twin (#24)
2026-11-04 docs/coarse-motor.md: the 28BYJ-48 and ULN2003 as the coarse approach motor (design, nothing built) (#27)
    * docs/coarse-motor.md: the 28BYJ-48 and ULN2003 as the coarse approach motor, designed and not built
    * docs/coarse-motor.md: the two-inverter circuit and its breadboard layout for the bench test
    * host/serve.cho: serve the UI from /srv/afm/ui, not a path under one user's home
    The path is a literal because narrow takes one; it named a single
    developer's home directory. The board's files now live under /srv/afm/ui
    (ui/README.md says so). Not compiled in this checkout: n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
    [shopping-list.xlsx]
2026-11-04 I5: the last scan on a page (metrics component, levelled image as a PNG), PNG encoder, report pipeline (#25)
2026-11-04 Twin image artifacts, bow levelling, and the parallel ADC in afm_top (LEDs dropped) (#26)
    * I5: the last scan on a page (metrics component, levelled image as a PNG), PNG encoder, report pipeline
    * twin image artifacts (tilt, bow, line offsets), scan_twin raw-trace mode 7, pin budget of the AD9226 recorded
    * image.level_bow: the bow along x taken out of the levelled image; twin artifact results
    * afm_top: the parallel ADC (CTRL.ADC_PAR) in place of the six LEDs, pins 15-20, 51-56, 79, 80; system test phase 9
    Co-Aut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
2026-11-04 docs/index.html: the tutorial with figures and hints (#29)
    * docs/index.html: the tutorial with figures and hints
    A roadmap of the 13 parts with their state, and a figure for the loop,
    the board link, the Pmod wiring from afm_top.cst, the fork's signal path,
    the etching bath, one piezo driver and the approach. Each part gets a
    hint. The page now says the first Farnell order is placed (2026-11-04).
    * docs/index.html: measure-as-you-go tables in nine tutorial parts
    Each lists what to measure, with what, the design or simulation value to
    expect, and what a wrong reading usually means. Values come from
    docs/amplifier.md, docs/first-ha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
2026-11-04 host/bench.cho: the first bench program (adc, dac, ramp) over the serial port (#30)
    adc N prints mean, spread and range of ADC0 and ADC1 and checks that conversions
    run; dac CH CODE bare holds a DAC at a code for a meter and puts it back; ramp CH
    STEPS bare steps a DAC and fits the ADC's response. Reads the identifier first.
    MANUAL mode bypasses the Z limit, so dac and ramp refuse without 'bare'.
    Compiles, and was run against a throwaway fake board on a pseudo-terminal;
    never run on a real board. docs/bench.md, docs/host.md and the tutorial tags
    are updated.
2026-11-08 Twin force proxy and soft sample (S9.3, part): scan-wide force, damage windows, indentation, tests
2026-11-08 OPT_RUN, OPT_DEFL, OPT_SUM (S9.5): the optical lever's slow outputs on the Pmod AD1 beside the parallel ADC; register table, Verilog, twin, system test phase 10
2026-11-08 Profile 2, liquid, in session: light checks and a gentler tap (S9.6)
    Profile 2 shares the fast-cantilever setup, turns on the optical lever (OPT_RUN),
    reads OPT_SUM and OPT_DEFL after every stage, taps at 90% (contact at 94%), and
    refuses with 81 (no light), 82 (light faded under 95%) and 83 (deflection out of
    range). The fading beam handed over by S9.4 is now refused. scan_twin takes
    profile 2. Limits are assumed; nothing measured.
2026-11-08 Alignment stage and the force in the report (S9.7)
    host/align.cho: a state machine over OPT_SUM with three refusals; host/align_twin.cho
    prints each step against the twin. scan.json carries the per-pixel force next to the
    image when a stiffness is given. Tests: align_test.cho, liquid_flow.sh. Nothing measured.
2026-11-08 docs/liquid.md: S9.1 scope, the two samples and the target force (a proposal)
2026-11-08 S9.10: safety plan for liquid, electronics, laser and biology (a draft, unreviewed)
2026-11-08 docs/spec.md: the resolution and signal-to-noise we ask of phases 1 and 2, each row traced, nothing measured
2026-11-09 docs/motor-retract.md: the rule for retracting by the coarse motor; MOTOR_MAX allows a move over the twin's Z range
2026-11-09 scan_twin argument 21 (step height); the Z range measured: a 20 nm step reads 7.2 nm at 10 nm; raising zmax gives code 0 on a dead image
2026-11-09 A spent step budget is refused with code 73, not reported as success
    At a 100 nm Z range the approach needs more than the 40,000 session steps scan_twin allows; the loop fell out with failure code 0 and a dead image. session.budget_spent turns that into 70 + the stage (73: approaching). Tested in tests/liquid_flow.sh; docs/liquid.md corrected in place.
2026-11-09 demo_twin, live_twin, twin_export: a spent step budget is refused with code 7x too
    Same check as scan_twin (session.budget_spent, last stage 99).
2026-11-09 HS1 and HS2: the frame-rate table, and the Z range rule (step budget, code 35)
    HS1: frame rate vs loop steps per pixel and scanner resonance, profiles 1 and 2; air Q 100 is refused with 21 (tests/hs_rate.sh).
    HS2: approach.worst_steps and check_budget refuse a range that cannot fit session.step_budget() with code 35; max_motor derived from gap_max; consume's hidden 40,000 cap now reads the budget. A 100 nm range completes and reads a 20 nm step; the 7.2 nm clip was the 10 nm range.
2026-11-09 HS3: an air cantilever (Q 100) tunes, and Q control in the twin
    Profile 1 settles 630 us per sweep point (was 37 us, which refused Q 100 with code 21) and sweeps a narrow line a second time, finely. sim/qcontrol.cho and board.set_qcontrol damp the lever (Q_eff = Q0 / (1 + g cos phi)); scan_twin takes the gain and phase error; an unstable feedback is refused with 85. At Q 100 the lag stays under 100 pm at 0.39 frames/s without control and 5.2 with a gain of 9.
2026-11-09 HS4: the lock-in window is not what limits the frame rate in the twin; no detector built
    A one-cycle window at equal frame time is no better than 18 samples even with gains tuned for each. What limits the rate is the loop gain rule and the Z scanner (issue #72). Adds scan_twin argument 24 (gain scale) to measure it.
2026-11-09 HS5: measure parachuting in the twin (airborne windows), and how much the per-pixel force map misses
    fl[44] and fl[45] count the detector windows with the tip a full free amplitude from the sample; scan_twin argument 26 prints them. On a 4 nm step the tip is airborne for the same number of windows at every line rate, which is 1.9% of the image at 1.55 frames/s and 13% at 10. More gain shortens it.
2026-11-09 A dynamic sample in the twin: a particle crossing, one circling, one fixed, one growing
    fl[46] selects it, fl[47] is the frame's start time; scan_twin arguments 27 to 29 image it and print the true surface at mid-frame. The default is the static sample, so earlier results are unchanged. tests/board_test.cho pins the motion.
2026-11-09 D1: diffusion with viscosity (Saffman-Delbrueck), tracking criteria, a stateless walk
    sim/membrane.cho: Saffman-Delbrueck D checked against Demery & Lacoste and the Wikipedia article, the two tracking criteria (Casuso's stays-in-frame, half the nearest-neighbour distance), a stateless 2D random walk. board.set_diffusion makes the static sample's particles diffuse; scan_twin arguments 27 to 30. The twin's images recover D within 10% at 10 frames/s. Fault found: the walk was not zero at t = 0.
2026-11-09 D6: force-curve analysis ported from nanoindent to cancho, with nanoindent as the oracle
    sim/forcecurve.cho: Hertz, Dimitriadis bonded, Garcia, Chadwick, Das/Connell and Sneddon laws; calibration, contact point, compliance correction; the closed-form modulus fit with the contact-point scan; the supported-bilayer analysis of one curve (breakthrough force, step height, four moduli, area compressibility). tests/forcecurve_test.cho reproduces nanoindent's numbers (commit c04820a). The oracle caught a missed fallback (contact-to-substrate height from the piezo Z), now ported and flagged as a weak point.
2026-11-09 D5: HS-AFM particle tracking and the diffusion coefficient, ported from nanoindent to cancho
    sim/tracking.cho: detection (4-connected components, intensity-weighted centroids), greedy nearest-neighbour linking, the mean-square displacement and its fit (MSD = 4 D t), streaming because a region holds 64 KiB. New: check refuses an estimate when the particles leave the field (3) or move over half the nearest-neighbour distance (4). tests/tracking_test.cho reproduces nanoindent's numbers (commit c04820a), including on the D1 movie: 30.36 against 30 nm^2/s put in.
2026-11-09 Real-time force-curve analysis and a live page; the twin's bilayer as a force-curve sample
    sim/livecurve.cho: the analysis while a curve is acquired (baseline, contact, running modulus per model, breakthrough), equal to the whole-curve analysis on the oracle's curve. sim/bilayer.cho: a supported bilayer with fluid, gel and melted phases and a thermally activated breakthrough (free stand-in kinetics). host/curve_twin.cho and ui/curve.cui/html/js: the page, seen working in a browser. forcecurve: slb_curve_nb and fit_modulus_from_contact, for two limitations of the oracle found with these curves. No papers or runtime files are committed.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
2026-11-09 Force-volume map of a mixed gel and fluid bilayer: domains sample, fv_twin producer, acceptance script, design and findings
2026-11-09 Histograms of the force-volume map: sim/histogram.cho, printed by fv_twin, checked in fvmap.sh; video and findings updated
2026-11-09 D7 slice 1: nucleation and growth of objects imaged at a frame time, the analysis, the closed-form checks and what they found
2026-11-10 D7 slice 3: the tip as a cause of rupture, the median filter measured (it breaks calibration), and a section on using the twin to design experiments
2026-11-10 D7: model adequacy check and the discrepancy matrix with fingerprints; Study gains the coverage at 15 s and 30 s
2026-11-10 Force-curve model library: six models, summaries from curves alone, the discrepancy matrix with fingerprints, identification against curves per experiment
2026-11-10 JPK reader: real files (encoder keys without data., a min-drop argument); first real-data result in the doc
    Found on 1,780 real curves: tag 16 (encoder keys), tag 4 (400 pN too large for a 0.285 N/m lever). At 50 pN, POPC-chol median 5.08 nN against the user's 5.15.
